ask4ska/ask4skaCyclone/Electronics/MEDIA/Arduino Mega+Ramps 1.4 + DRV8825.jpg

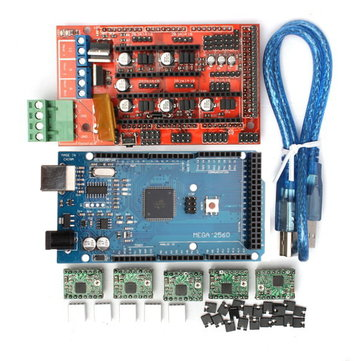
Electronics/MEDIA/Arduino Mega+Ramps 1.4 + DRV8825.jpg
