ask4ska/ask4skaCyclone/Electronics/MEDIA/NEMA_17.JPG

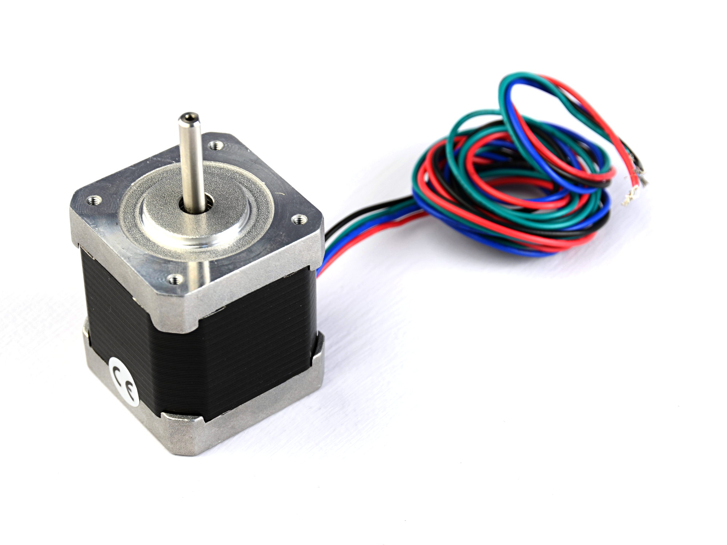
Electronics/MEDIA/NEMA_17.JPG
