ask4ska/ask4skaCyclone/Electronics/MEDIA/End Stop.jpg

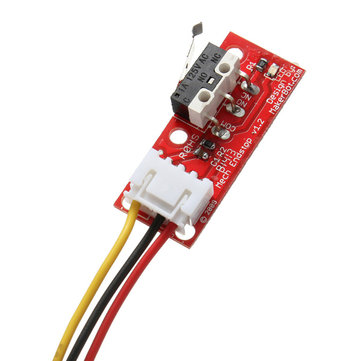
Electronics/MEDIA/End Stop.jpg
