ask4ska/ask4skaCyclone/Piezas y planos/Dremel Assembly.SLDASM

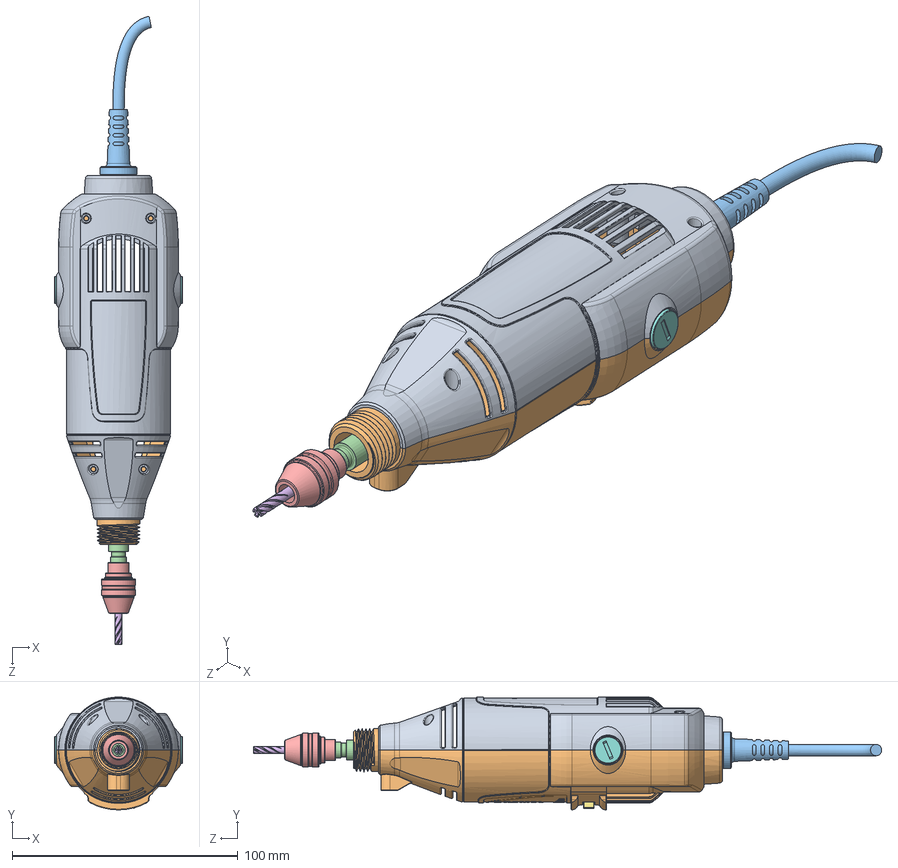
[picture p55: CAD file, 2017-06-02]
Piezas y planos/Dremel Assembly.SLDASM
56.7 x 50.0 x 278.4 mm
Dremel Left Half
Dremel Right Half
Dremel Chord
Dremel Chuck Mount
Dremel Chuck
End Mill for Dremel
Dremel Speed Lever
Dremel Motor Adjust x 2
