ask4ska/ask4skaCyclone/Piezas y planos/Carcassa.SLDASM

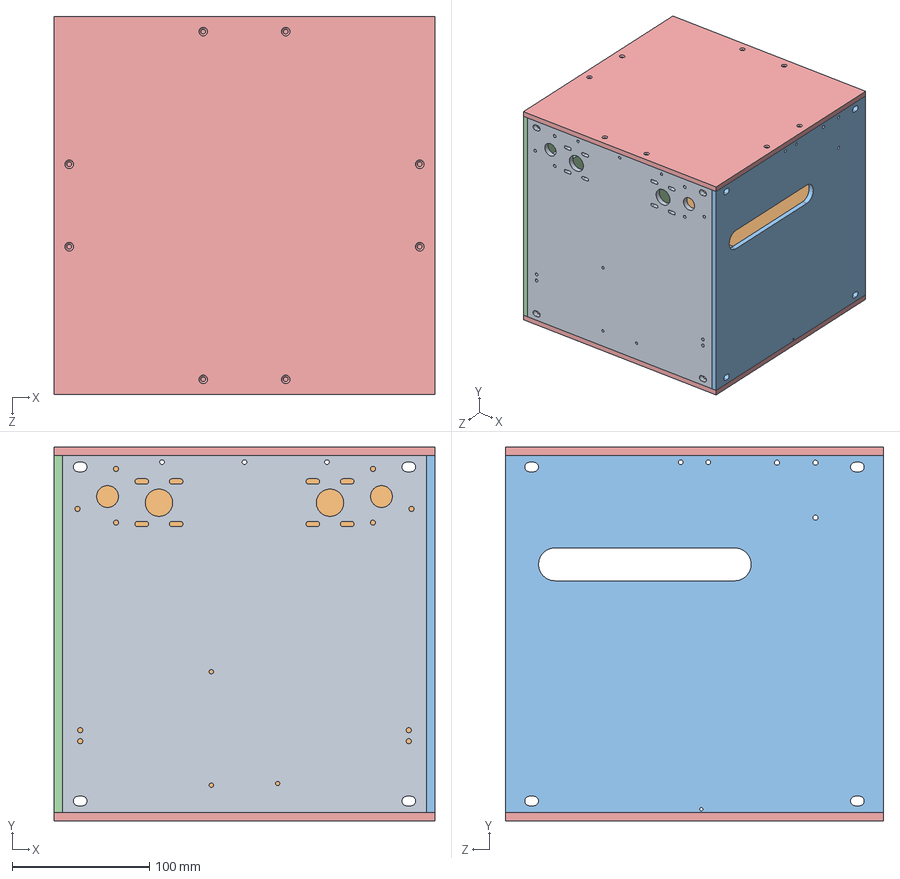
[picture p56: CAD file, 2017-06-02]
Piezas y planos/Carcassa.SLDASM
277.0 x 272.0 x 275.0 mm
carcassa darrere
carcassa davant
carcassa dreta
carcassa esquerra
carcassa tapa x 2
