ask4ska/ask4skaCyclone/Piezas y planos/Laser.SLDASM

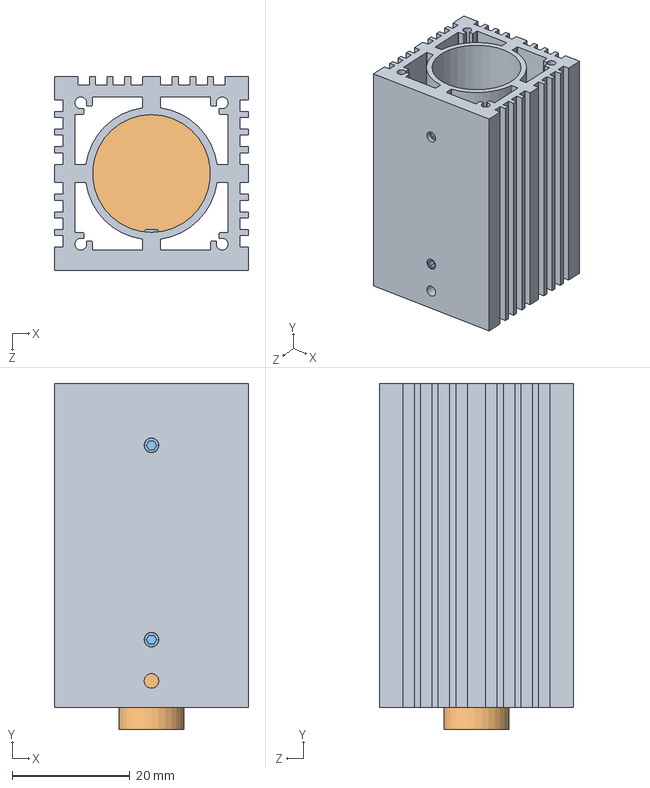
[picture p57: CAD file, 2017-06-02]
Piezas y planos/Laser.SLDASM
33.0 x 58.8 x 33.0 mm
Disipador pasiu
Làser
socket set screw flat point_iso x 2
