ask4ska/ask4skaCyclone/Piezas y planos/NEMA 17.SLDASM

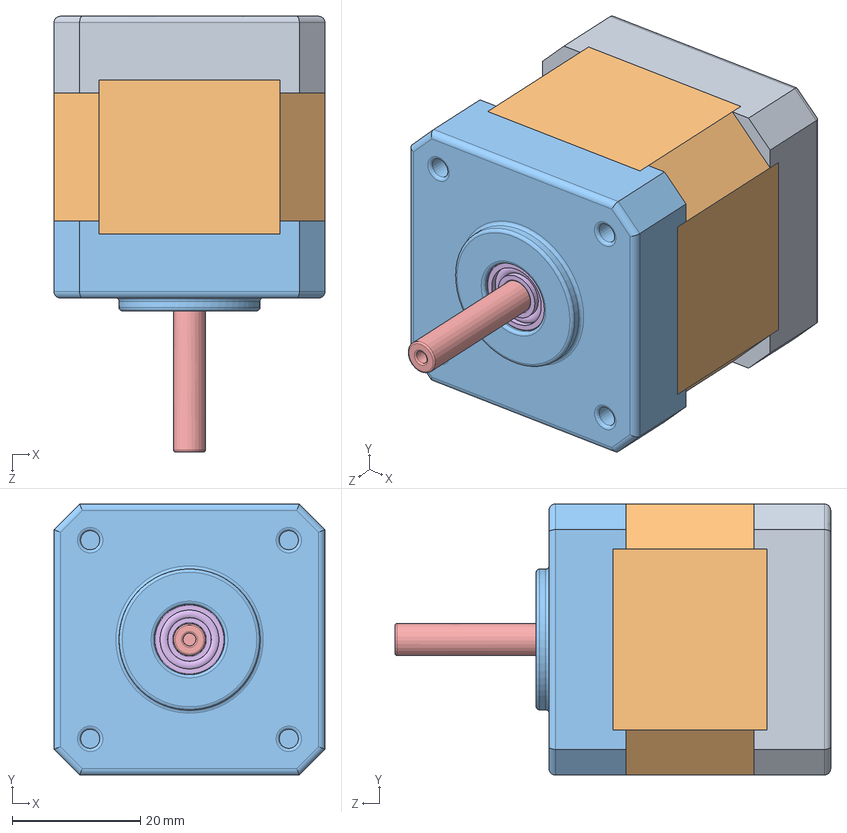
[picture p58: CAD file, 2017-06-02]
Piezas y planos/NEMA 17.SLDASM
42.3 x 42.3 x 68.0 mm
Base
Cuerpo
Tapa
pan cross head_am x 4
Eje
instrument ball bearing_68_am x 2
