ask4ska/ask4skaCyclone/Piezas y planos/cadenaens.SLDASM

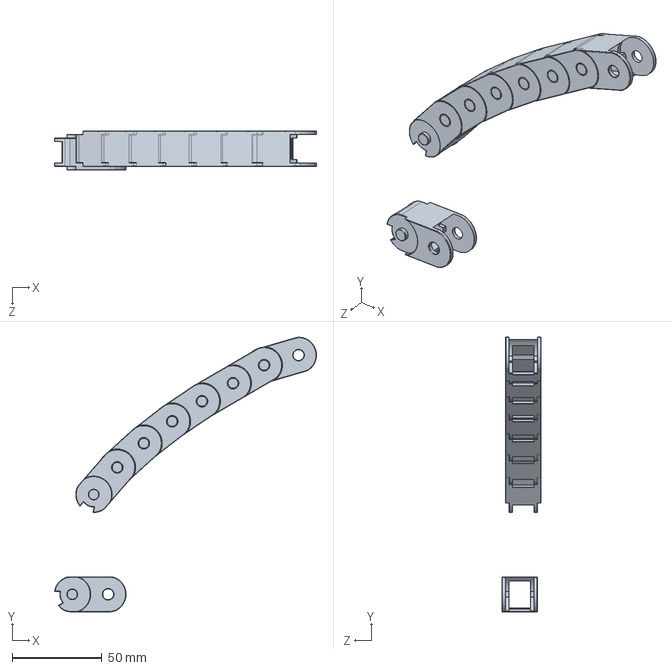
[picture p59: CAD file, 2017-06-02]
Piezas y planos/cadenaens.SLDASM
145.9 x 152.9 x 22.0 mm
cadenamod x 8
