ask4ska/ask4skaCyclone/Piezas y planos/G3D_Mech_Endstop.SLDASM

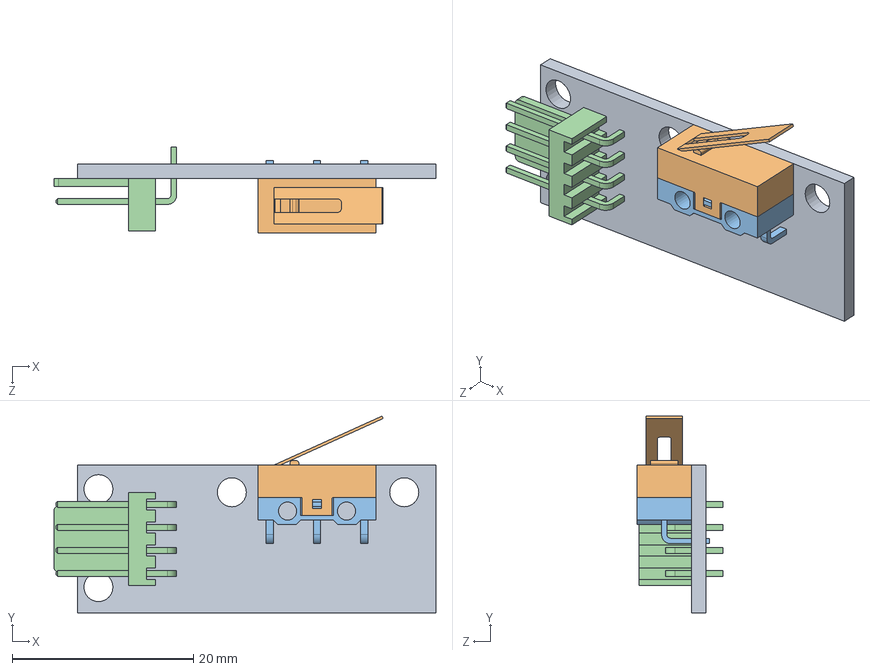
[picture p60: CAD file, 2017-06-02]
Piezas y planos/G3D_Mech_Endstop.SLDASM
42.1 x 21.7 x 9.46 mm
PCB_Mech_Endstop
Corpo1
Corpo2
SIL_4_P_90DEG
