ask4ska/ask4skaCyclone/Piezas y planos/Endstop.SLDASM

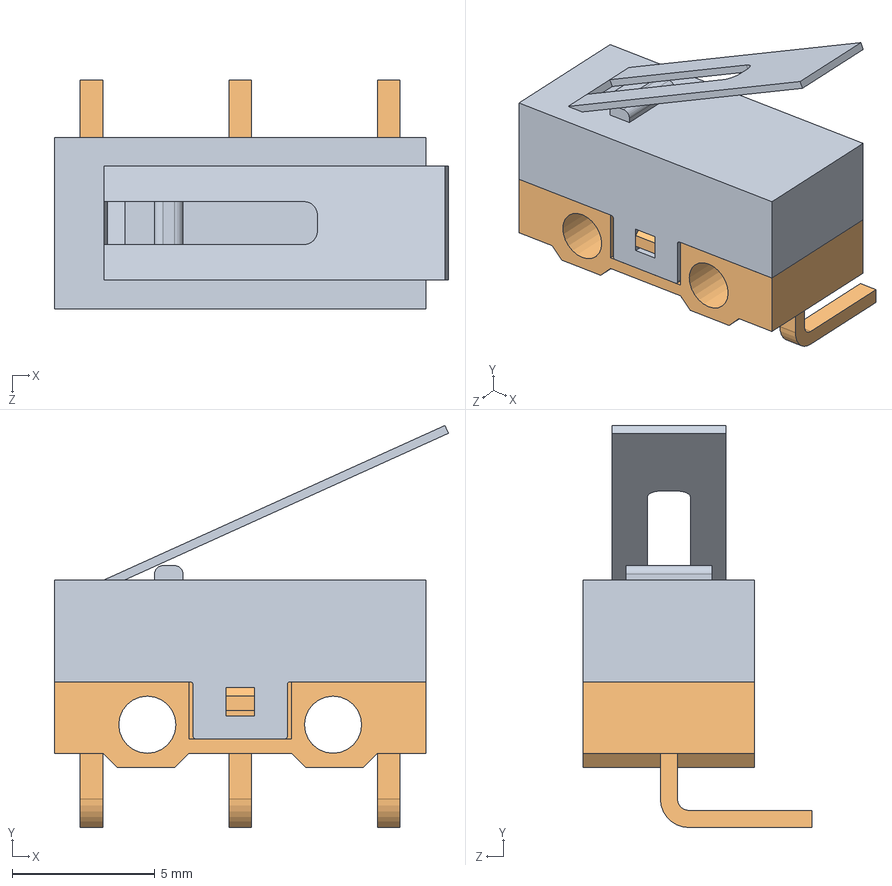
[picture p61: CAD file, 2017-06-02]
Piezas y planos/Endstop.SLDASM
13.8 x 14.1 x 8.00 mm
Corpo1
Corpo2
