ask4ska/ask4skaCyclone/Piezas y planos/Corpo1.SLDPRT

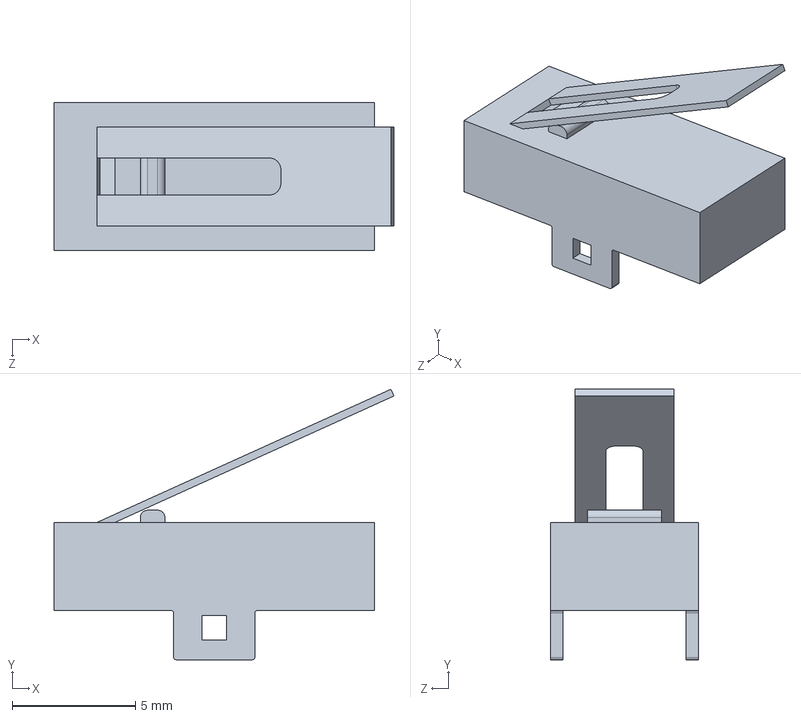
[picture p62: CAD file, 2017-06-02]
Piezas y planos/Corpo1.SLDPRT
13.8 x 11.0 x 6.00 mm
