ask4ska/ask4skaCyclone/Piezas y planos/Chapa desplegada - carcassa tapasota.DXF

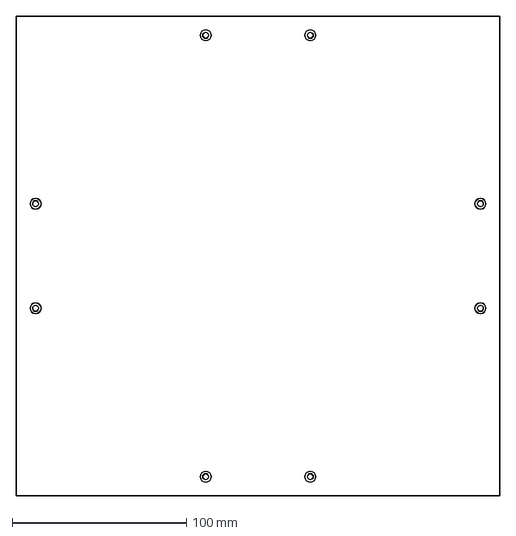
[picture p63: CAD file, 2017-06-02]
Piezas y planos/Chapa desplegada - carcassa tapasota.DXF
277.0 x 275.0 mm
