ask4ska/ask4skaCyclone/Piezas y planos/cadenamod.SLDPRT

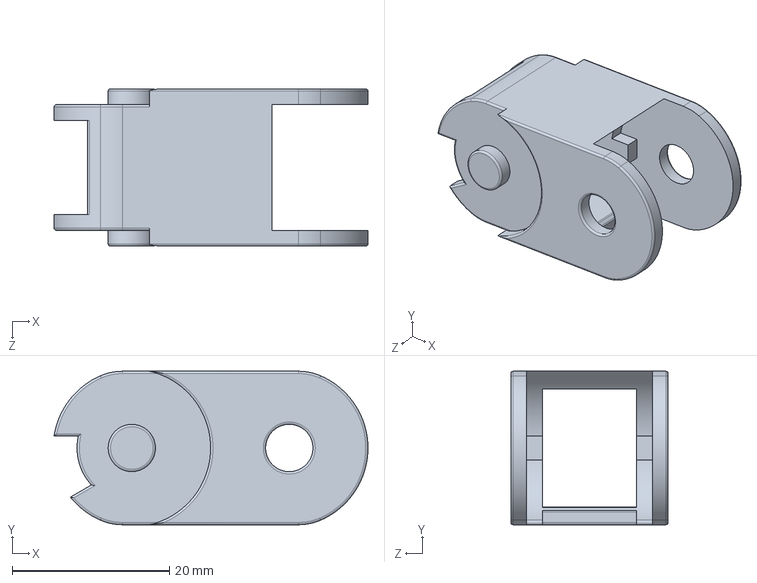
[picture p64: CAD file, 2017-06-02]
Piezas y planos/cadenamod.SLDPRT
39.9 x 19.5 x 20.0 mm
