ask4ska/ask4skaCyclone/Piezas y planos/carcassa dreta.SLDPRT

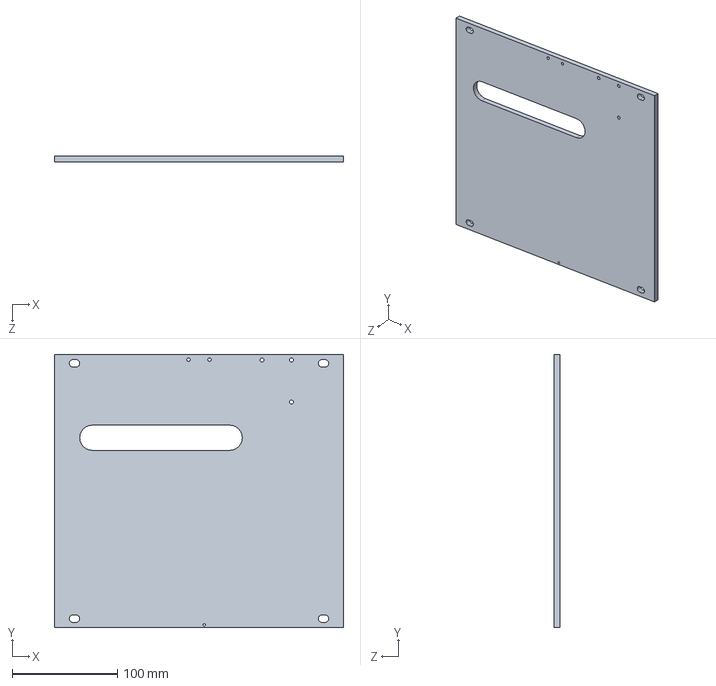
[picture p65: CAD file, 2017-06-02]
Piezas y planos/carcassa dreta.SLDPRT
275.0 x 260.0 x 6.00 mm
