ask4ska/ask4skaCyclone/Piezas y planos/pan cross head_am.sldprt

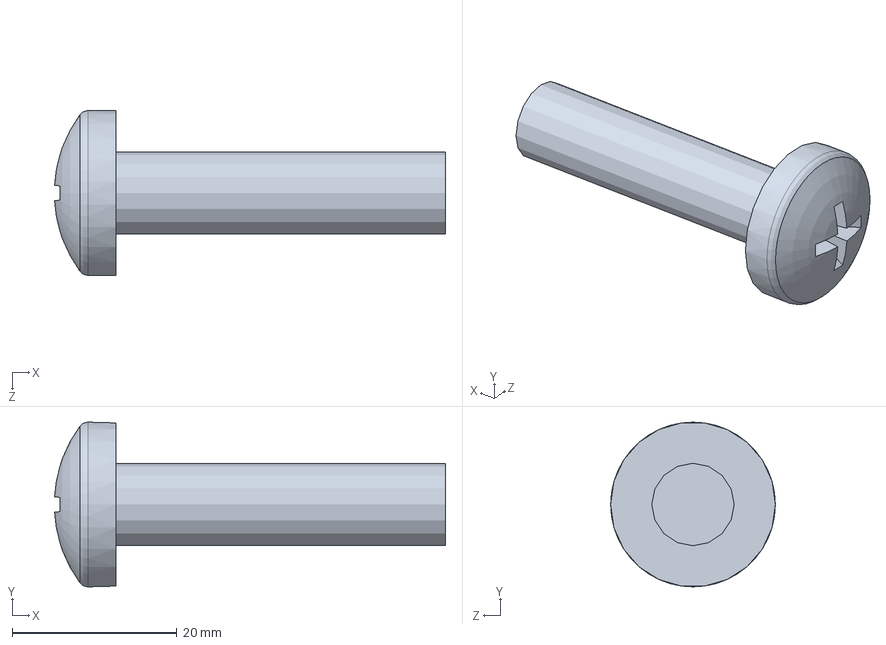
[picture p66: CAD file, 2017-06-02]
Piezas y planos/pan cross head_am.sldprt
47.4 x 20.0 x 20.0 mm
