ask4ska/ask4skaCyclone/Piezas y planos/End Mill for Dremel.SLDPRT

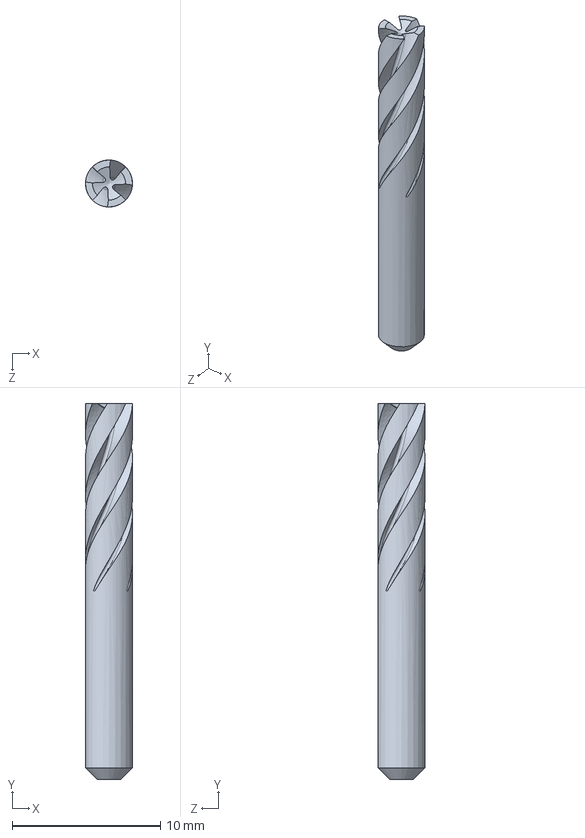
[picture p67: CAD file, 2017-06-02]
Piezas y planos/End Mill for Dremel.SLDPRT
3.17 x 25.4 x 3.17 mm
