ask4ska/ask4skaCyclone/Piezas y planos/Engranatge XY NEMAA.SLDPRT

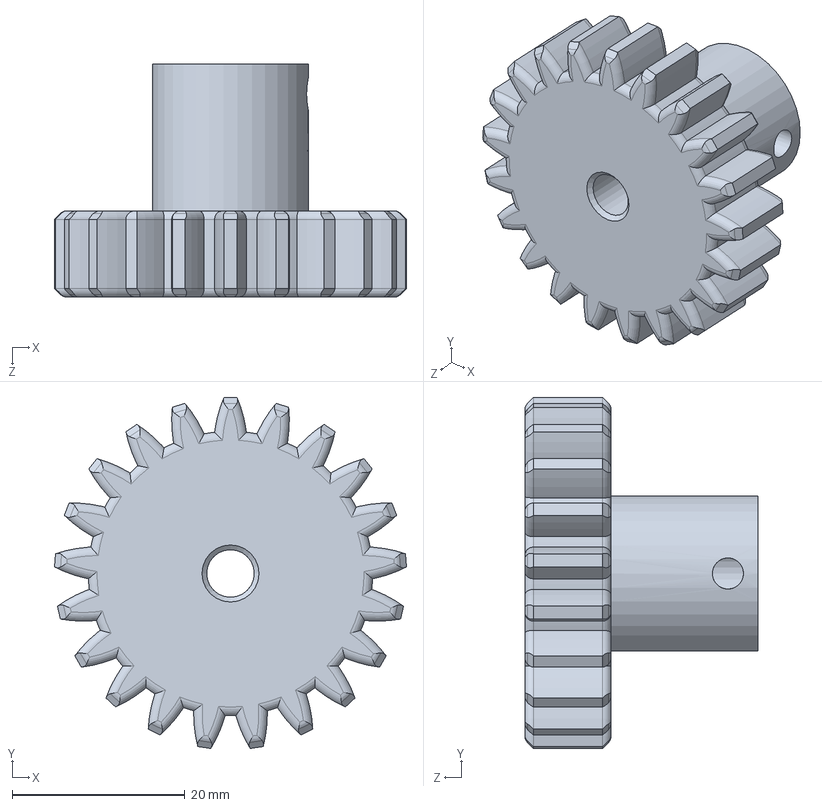
[picture p68: CAD file, 2017-06-02]
Piezas y planos/Engranatge XY NEMAA.SLDPRT
40.7 x 40.6 x 27.0 mm
