ask4ska/ask4skaCyclone/Piezas y planos/AutolevelV.2.2.SLDPRT

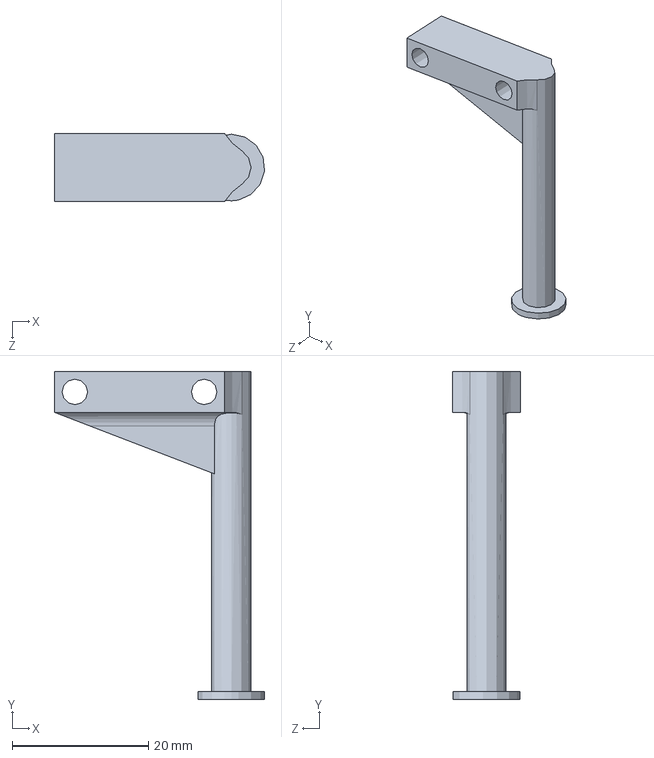
[picture p69: CAD file, 2017-06-02]
Piezas y planos/AutolevelV.2.2.SLDPRT
30.9 x 48.2 x 10.0 mm
