ask4ska/ask4skaCyclone/Piezas y planos/Chapa desplegada - carcassa darrere.DXF

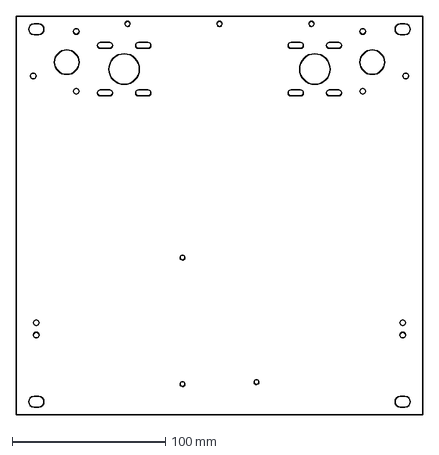
[picture p70: CAD file, 2017-06-02]
Piezas y planos/Chapa desplegada - carcassa darrere.DXF
265.0 x 260.0 mm
