ask4ska/ask4skaCyclone/Piezas y planos/Anclatge 75.SLDPRT

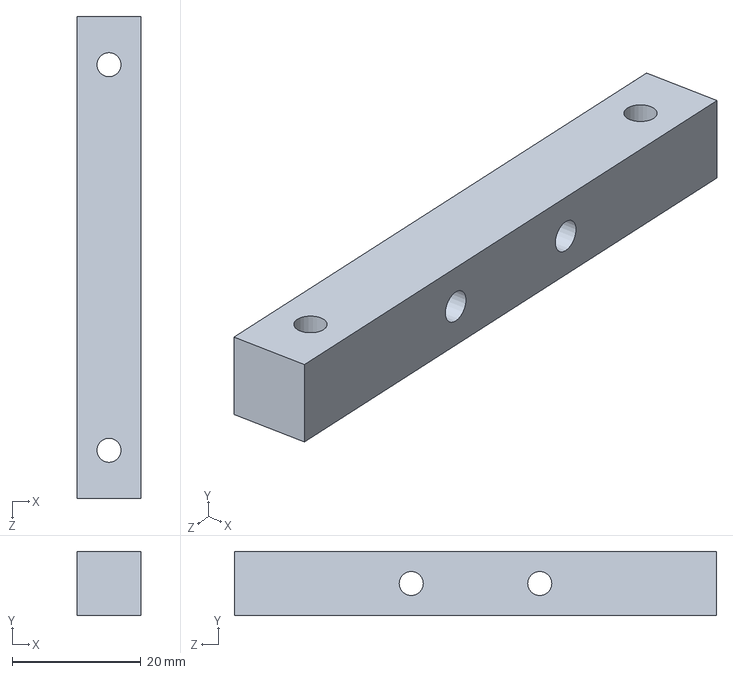
[picture p71: CAD file, 2017-06-02]
Piezas y planos/Anclatge 75.SLDPRT
10.0 x 10.0 x 75.0 mm
