ask4ska/ask4skaCyclone/Piezas y planos/carcassa darrere.SLDPRT

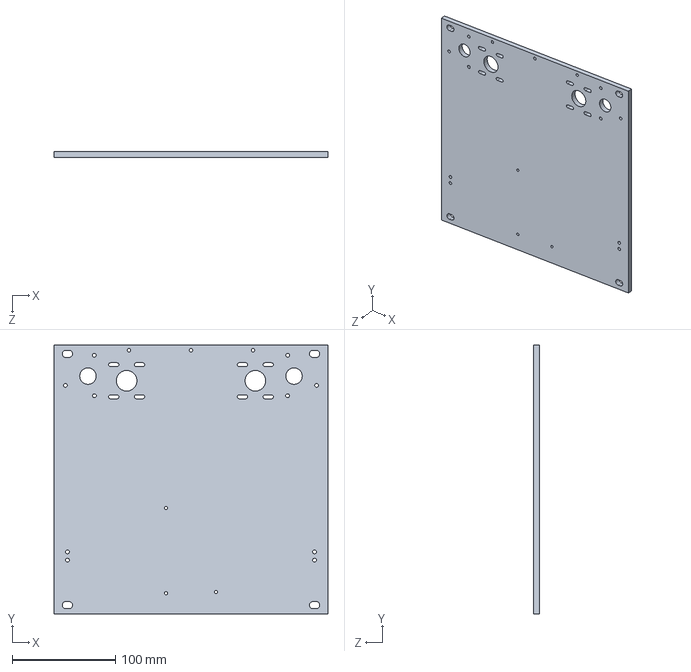
[picture p72: CAD file, 2017-06-02]
Piezas y planos/carcassa darrere.SLDPRT
265.0 x 260.0 x 6.00 mm
