ask4ska/ask4skaCyclone/Piezas y planos/Dremel Chuck Mount.SLDPRT

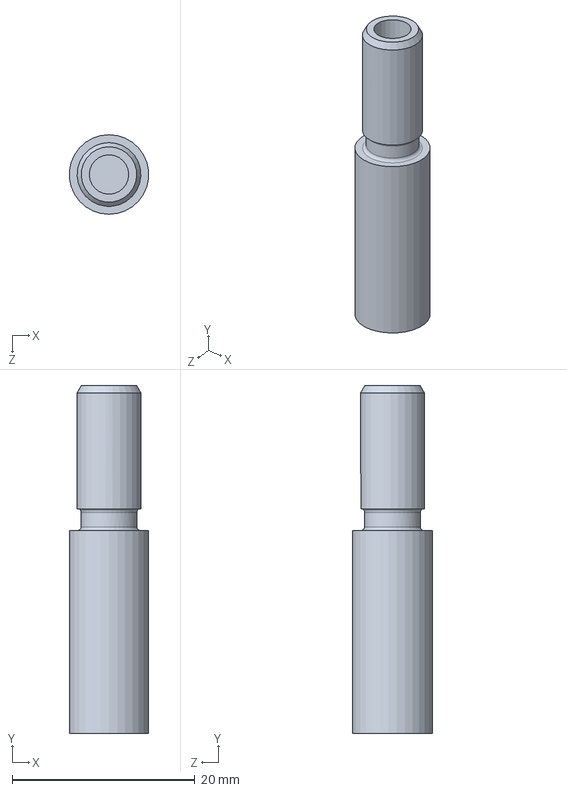
[picture p73: CAD file, 2017-06-02]
Piezas y planos/Dremel Chuck Mount.SLDPRT
8.66 x 38.1 x 8.71 mm
