ask4ska/ask4skaCyclone/Piezas y planos/pinza2.SLDPRT

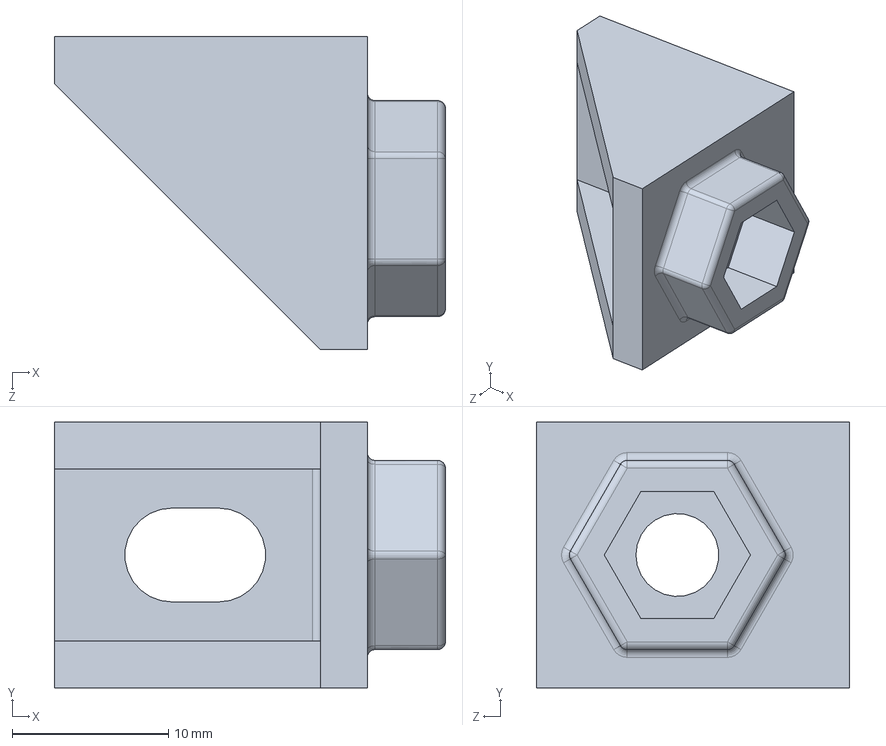
[picture p74: CAD file, 2017-06-02]
Piezas y planos/pinza2.SLDPRT
25.0 x 17.0 x 20.0 mm
