ask4ska/ask4skaCyclone/Piezas y planos/carcassa tapa.SLDPRT

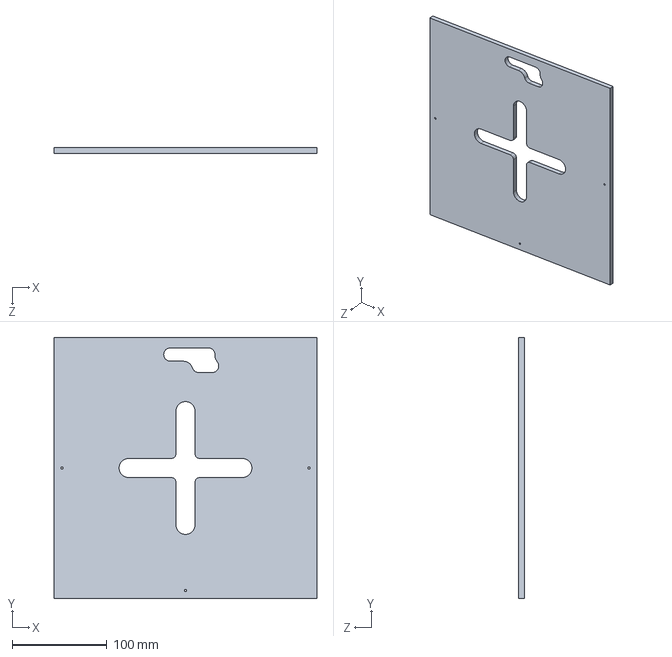
[picture p75: CAD file, 2017-06-02]
Piezas y planos/carcassa tapa.SLDPRT
277.0 x 275.0 x 6.00 mm
