ask4ska/ask4skaCyclone/Piezas y planos/Plataforma base.SLDPRT

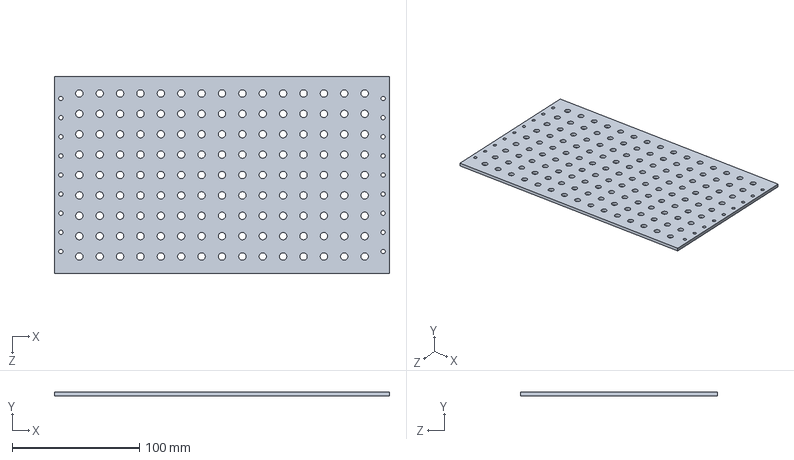
[picture p76: CAD file, 2017-06-02]
Piezas y planos/Plataforma base.SLDPRT
263.0 x 3.00 x 155.0 mm
