ask4ska/ask4skaCyclone/Piezas y planos/Abraçadera dremel.SLDPRT

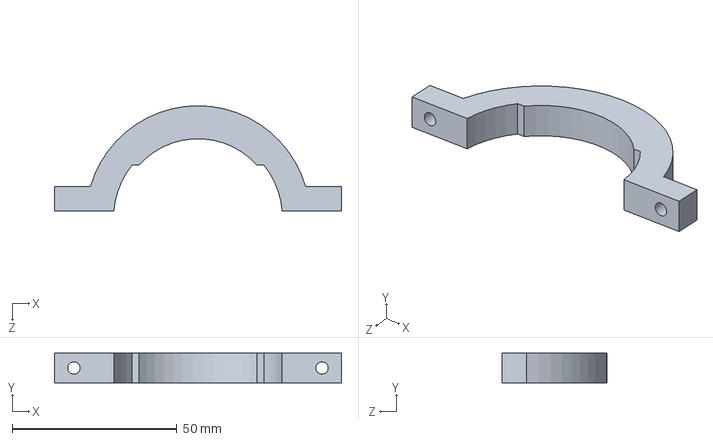
[picture p77: CAD file, 2017-06-02]
Piezas y planos/Abraçadera dremel.SLDPRT
87.1 x 9.00 x 32.0 mm
