ask4ska/ask4skaCyclone/Piezas y planos/Dremel Left Half.SLDPRT

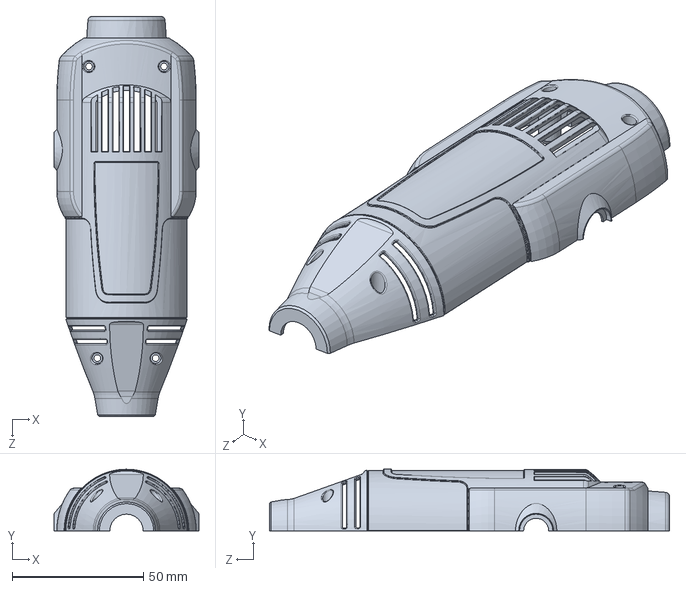
[picture p78: CAD file, 2017-06-02]
Piezas y planos/Dremel Left Half.SLDPRT
55.1 x 23.5 x 152.4 mm
