ask4ska/ask4skaCyclone/Piezas y planos/Dremel Speed Lever.sldprt

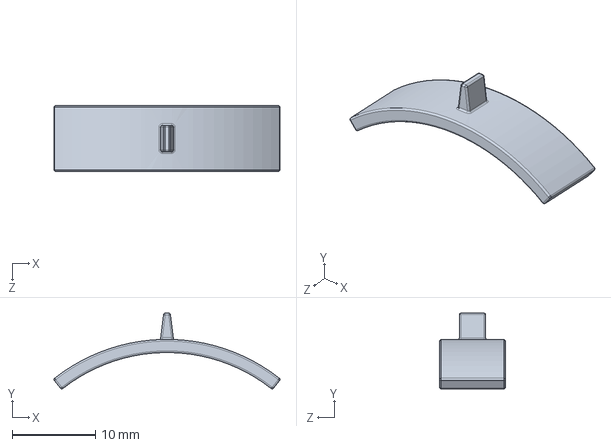
[picture p79: CAD file, 2017-06-02]
Piezas y planos/Dremel Speed Lever.sldprt
27.2 x 9.12 x 7.94 mm
