ask4ska/ask4skaCyclone/Piezas y planos/Base.SLDPRT

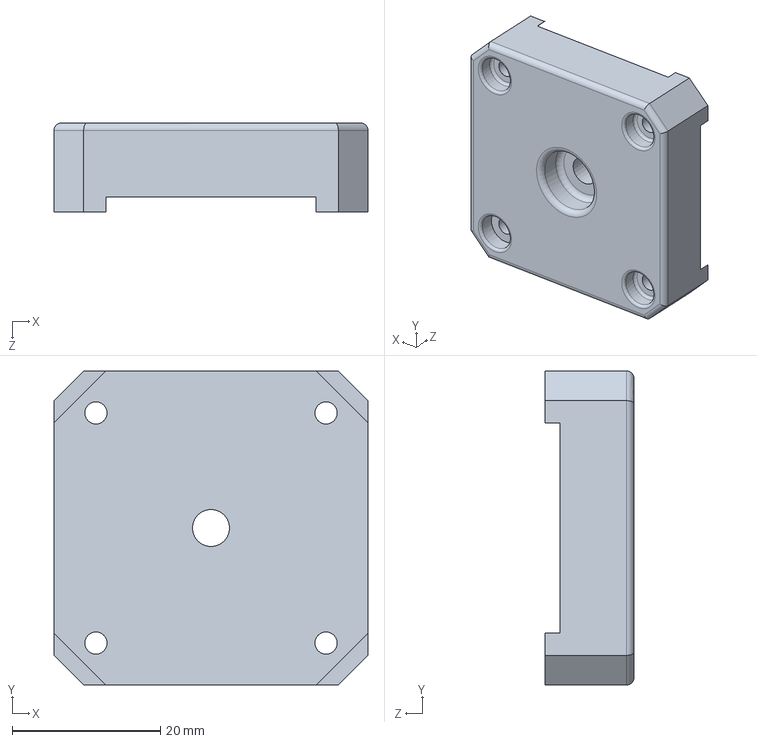
[picture p80: CAD file, 2017-06-02]
Piezas y planos/Base.SLDPRT
42.3 x 42.3 x 12.0 mm
