ask4ska/ask4skaCyclone/Piezas y planos/carro superior.SLDPRT

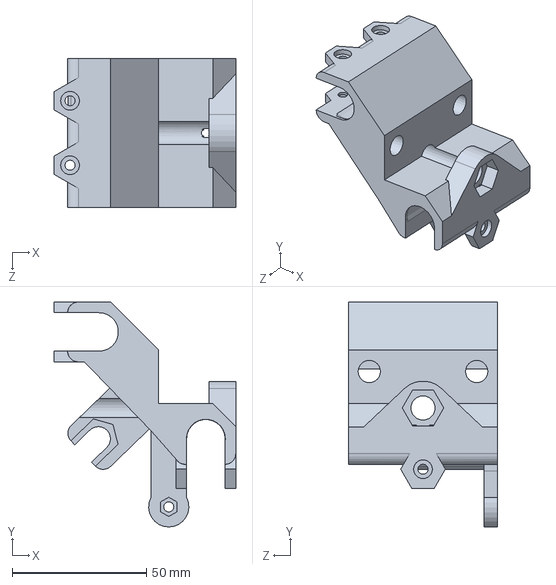
[picture p81: CAD file, 2017-06-02]
Piezas y planos/carro superior.SLDPRT
67.6 x 83.8 x 55.5 mm
