ask4ska/ask4skaCyclone/Piezas y planos/Matriz ex1.1.SLDPRT

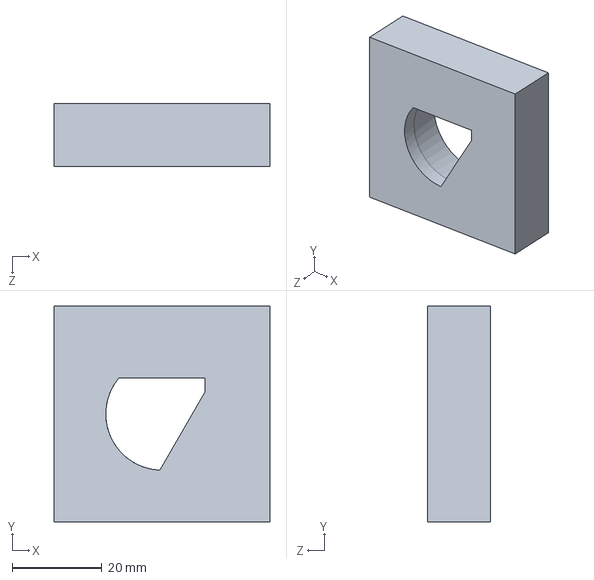
[picture p82: CAD file, 2017-06-02]
Piezas y planos/Matriz ex1.1.SLDPRT
48.0 x 48.0 x 14.0 mm
