ask4ska/ask4skaCyclone/Piezas y planos/Distanciador RAMPS2.SLDPRT

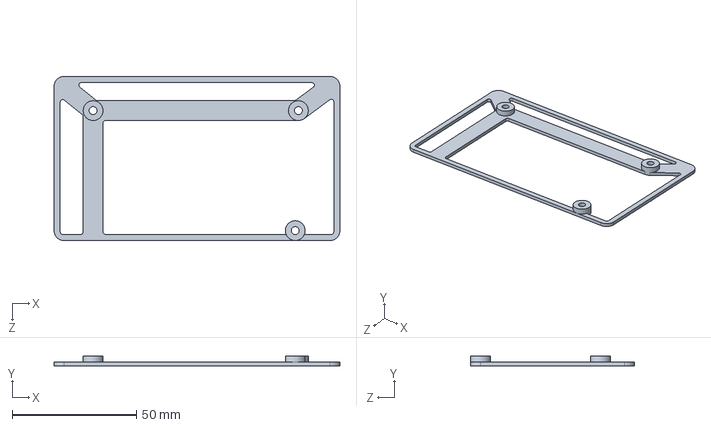
[picture p83: CAD file, 2017-06-02]
Piezas y planos/Distanciador RAMPS2.SLDPRT
115.0 x 4.00 x 66.0 mm
