ask4ska/ask4skaCyclone/Piezas y planos/Engranatge XY rosca.SLDPRT

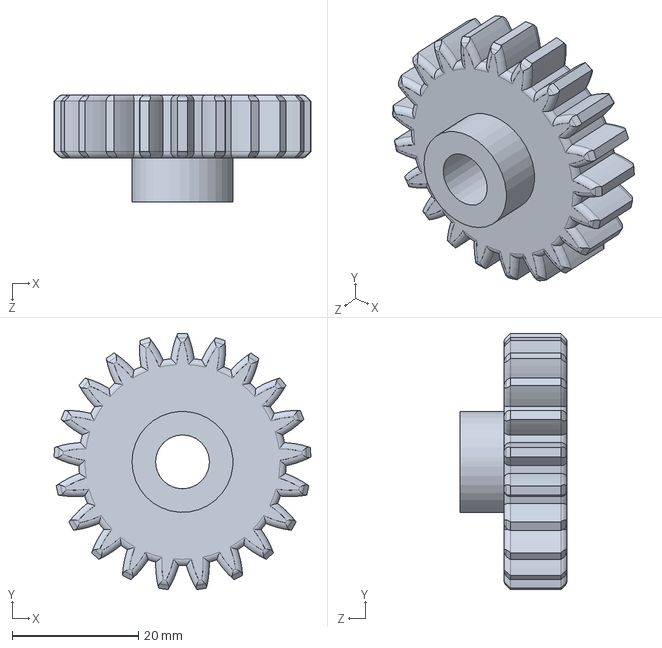
[picture p84: CAD file, 2017-06-02]
Piezas y planos/Engranatge XY rosca.SLDPRT
40.7 x 40.6 x 17.0 mm
