ask4ska/ask4skaCyclone/Piezas y planos/FijadorVarillaLisa.SLDPRT

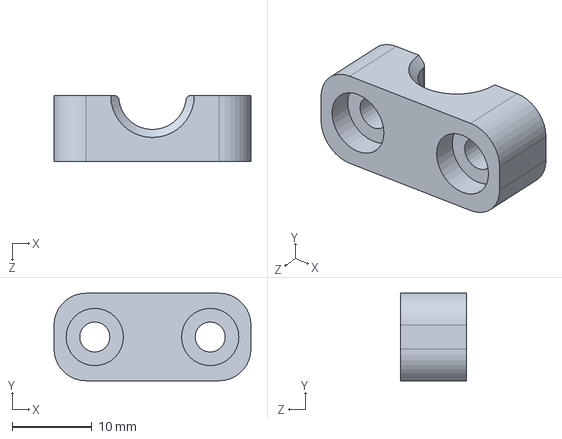
[picture p85: CAD file, 2017-06-02]
Piezas y planos/FijadorVarillaLisa.SLDPRT
24.8 x 11.0 x 8.25 mm
