ask4ska/ask4skaCyclone/Piezas y planos/FijadorVarillaLisa superior.SLDPRT

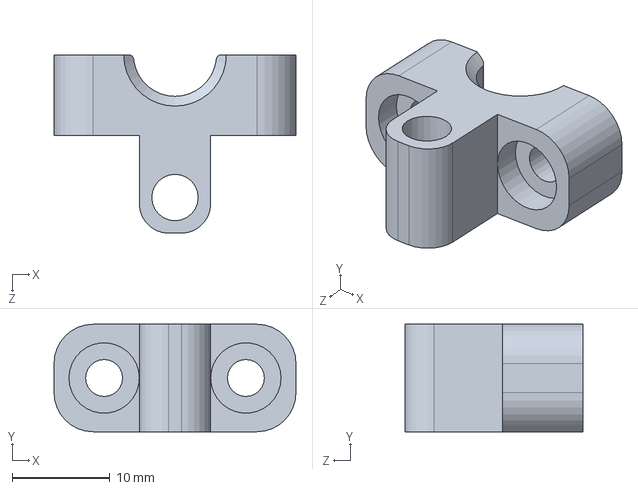
[picture p86: CAD file, 2017-06-02]
Piezas y planos/FijadorVarillaLisa superior.SLDPRT
24.8 x 11.0 x 18.2 mm
