ask4ska/ask4skaCyclone/Piezas y planos/Dremel Chuck.SLDPRT

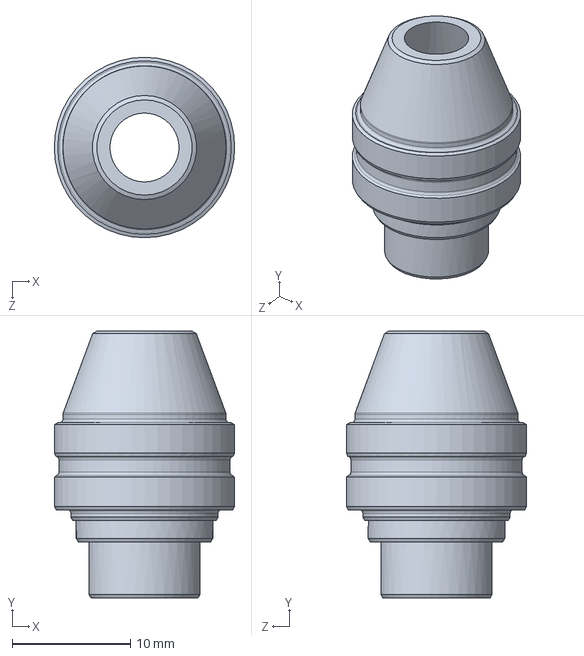
[picture p87: CAD file, 2017-06-02]
Piezas y planos/Dremel Chuck.SLDPRT
15.2 x 22.6 x 15.2 mm
