ask4ska/ask4skaCyclone/Piezas y planos/Esquinas.SLDPRT

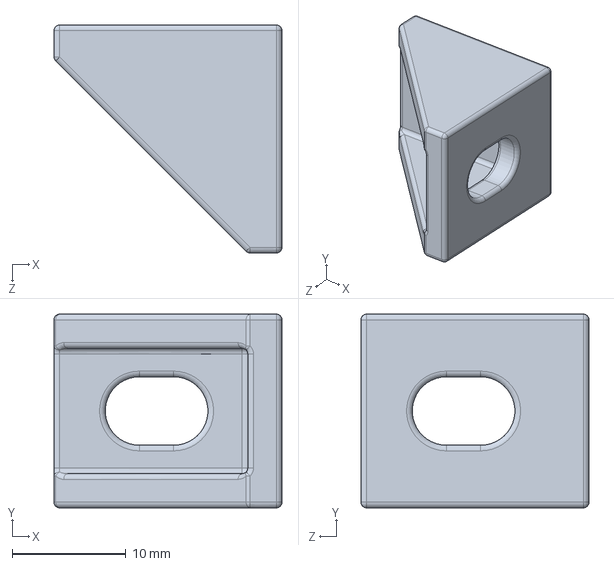
[picture p88: CAD file, 2017-06-02]
Piezas y planos/Esquinas.SLDPRT
20.0 x 17.0 x 20.0 mm
