ask4ska/ask4skaCyclone/Piezas y planos/Peça a mecanitzar.SLDPRT

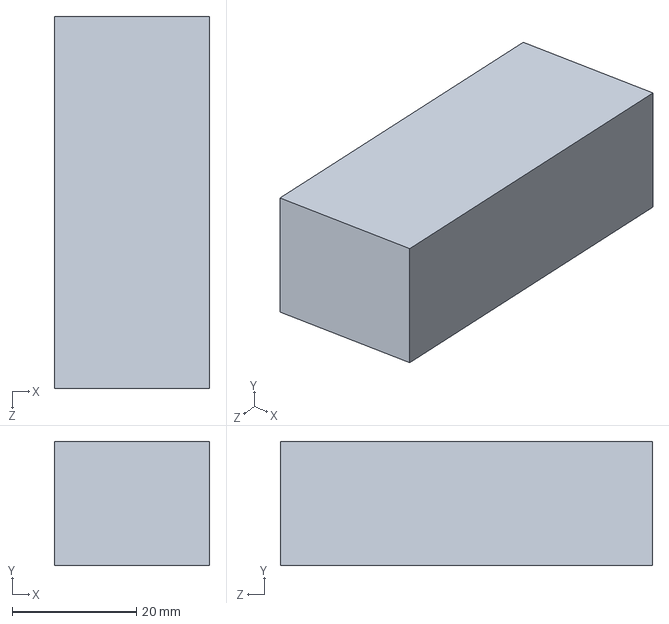
[picture p89: CAD file, 2017-06-02]
Piezas y planos/Peça a mecanitzar.SLDPRT
25.0 x 20.0 x 60.0 mm
