ask4ska/ask4skaCyclone/Piezas y planos/Anclatge 155.SLDPRT

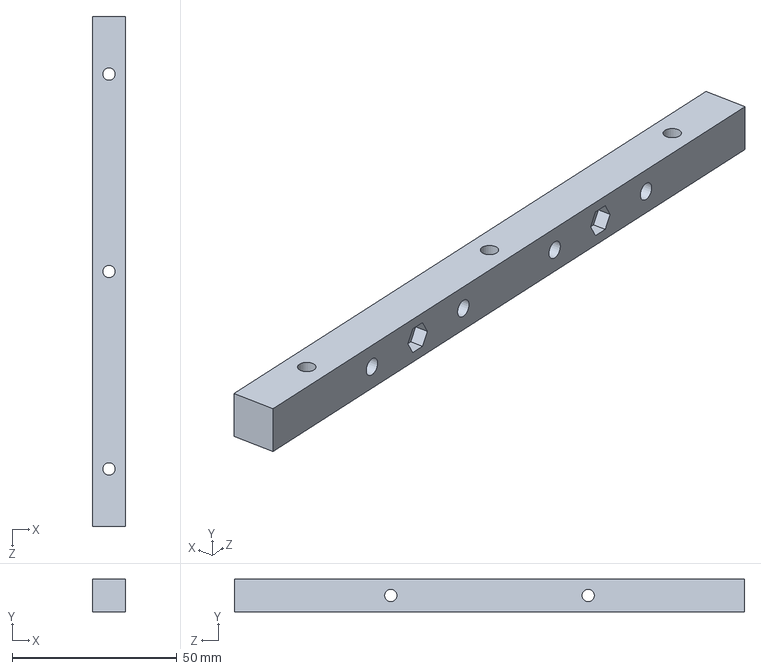
[picture p90: CAD file, 2017-06-02]
Piezas y planos/Anclatge 155.SLDPRT
10.0 x 10.0 x 155.0 mm
