ask4ska/ask4skaCyclone/Piezas y planos/PCB_Mech_Endstop.SLDPRT

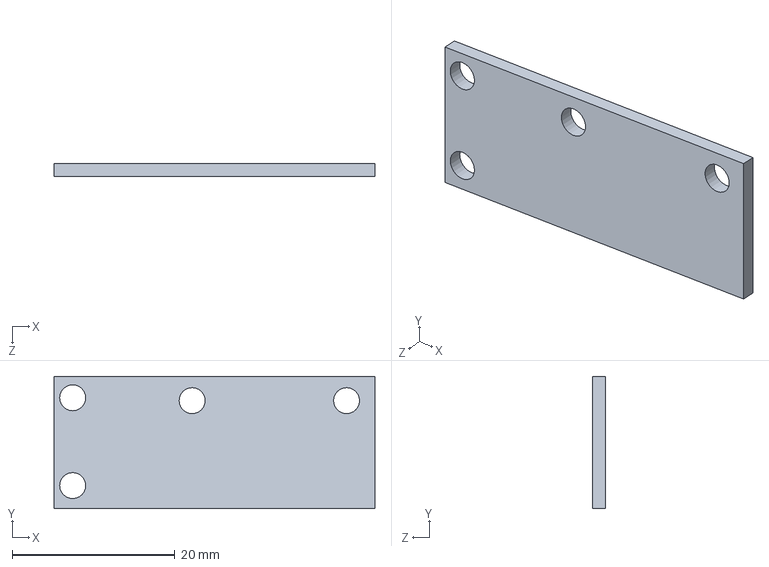
[picture p91: CAD file, 2017-06-02]
Piezas y planos/PCB_Mech_Endstop.SLDPRT
39.5 x 16.3 x 1.60 mm
