ask4ska/ask4skaCyclone/Piezas y planos/Muelle D11mm x H15mm.SLDPRT

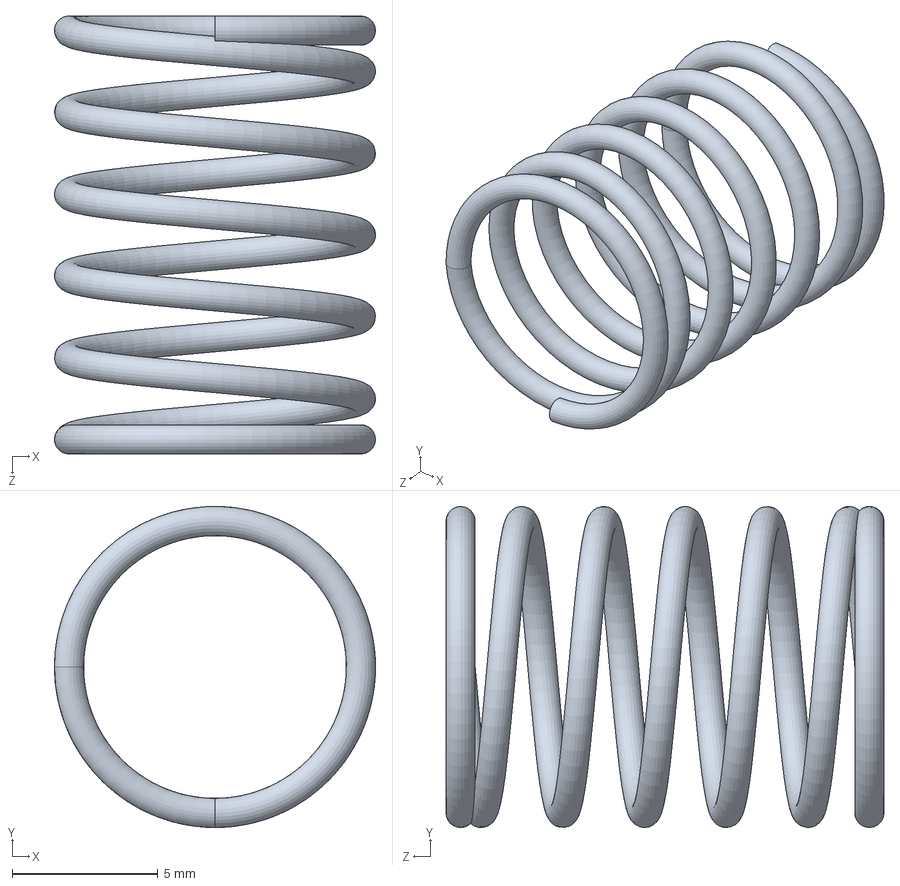
[picture p92: CAD file, 2017-06-02]
Piezas y planos/Muelle D11mm x H15mm.SLDPRT
11.0 x 11.0 x 15.0 mm
