ask4ska/ask4skaCyclone/Piezas y planos/Chapa desplegada - carcassa davant.DXF

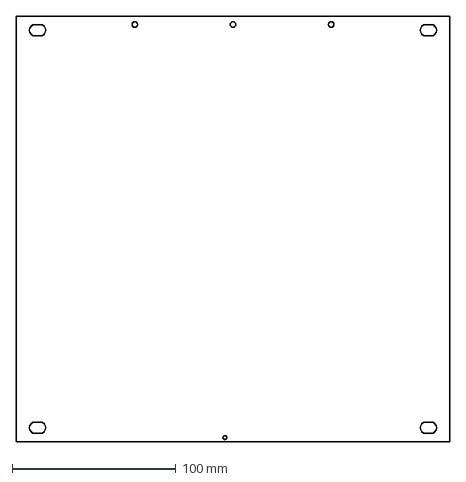
[picture p93: CAD file, 2017-06-02]
Piezas y planos/Chapa desplegada - carcassa davant.DXF
265.0 x 260.0 mm
