ask4ska/ask4skaCyclone/Piezas y planos/Chapa desplegada - carcassa tapa.DXF

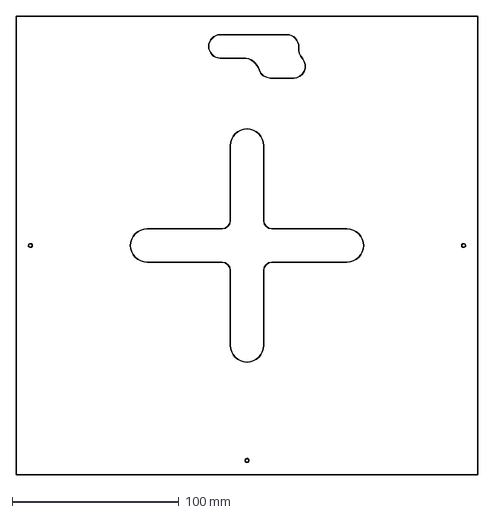
[picture p94: CAD file, 2017-06-02]
Piezas y planos/Chapa desplegada - carcassa tapa.DXF
277.0 x 275.0 mm
