ask4ska/ask4skaCyclone/Piezas y planos/Engranatge Z rosca.SLDPRT

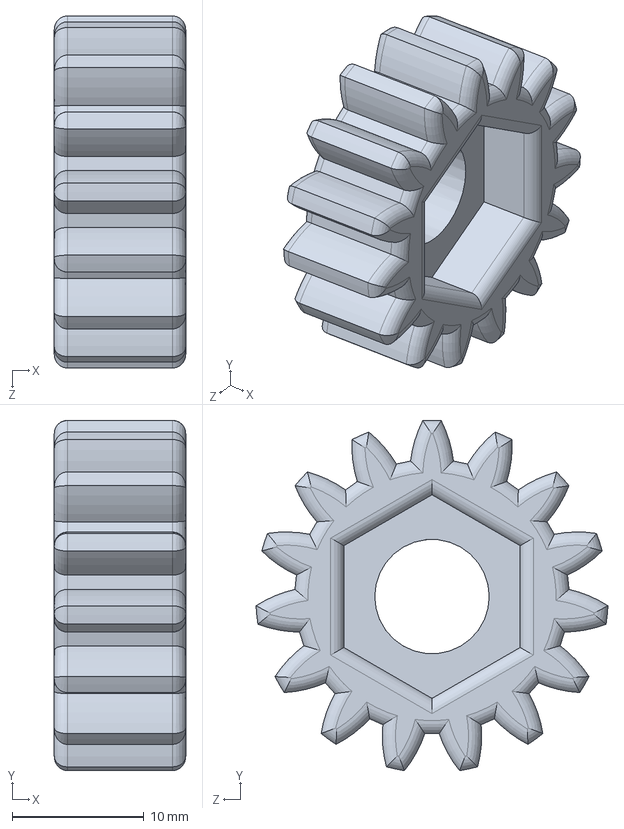
[picture p95: CAD file, 2017-06-02]
Piezas y planos/Engranatge Z rosca.SLDPRT
10.0 x 26.6 x 26.8 mm
