ask4ska/ask4skaCyclone/Piezas y planos/Disipador pasiu.SLDPRT

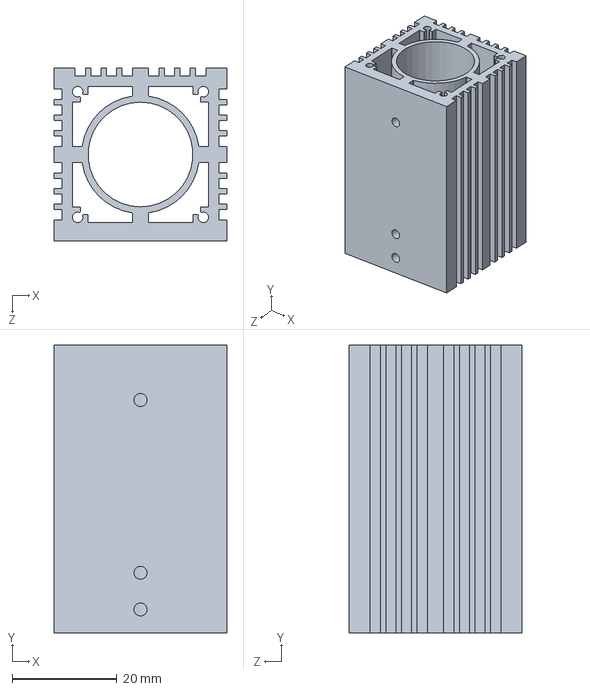
[picture p96: CAD file, 2017-06-02]
Piezas y planos/Disipador pasiu.SLDPRT
33.0 x 55.0 x 33.0 mm
