ask4ska/ask4skaCyclone/Piezas y planos/Dremel Right Half.SLDPRT

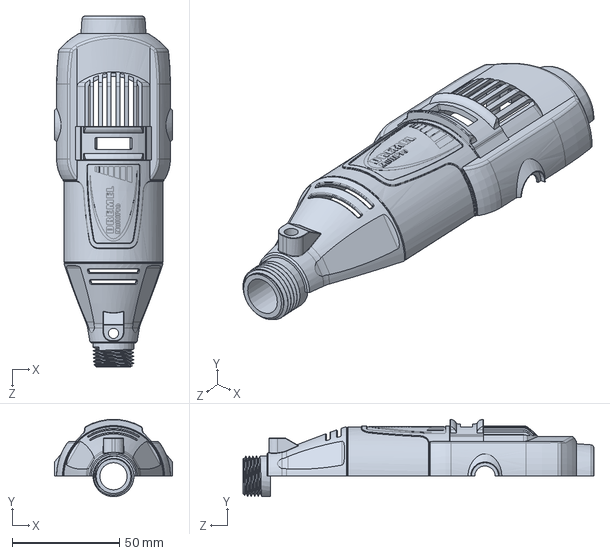
[picture p97: CAD file, 2017-06-02]
Piezas y planos/Dremel Right Half.SLDPRT
55.1 x 36.0 x 163.5 mm
