ask4ska/ask4skaCyclone/Piezas y planos/Cuerpo.SLDPRT

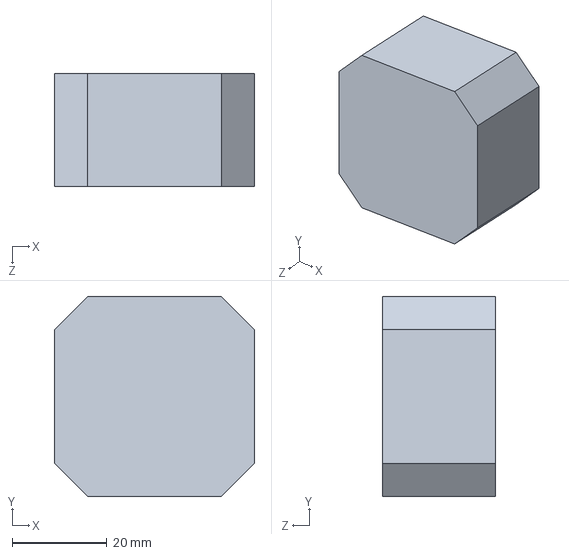
[picture p98: CAD file, 2017-06-02]
Piezas y planos/Cuerpo.SLDPRT
42.3 x 42.3 x 24.0 mm
