ask4ska/ask4skaCyclone/Piezas y planos/Làser.SLDPRT

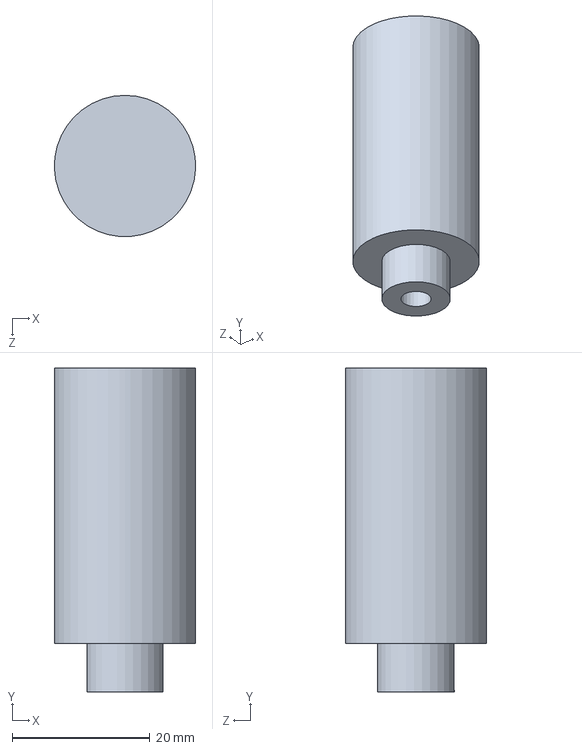
[picture p99: CAD file, 2017-06-02]
Piezas y planos/Làser.SLDPRT
20.5 x 47.0 x 20.5 mm
