ask4ska/ask4skaCyclone/Piezas y planos/Dremel Motor Adjust.SLDPRT

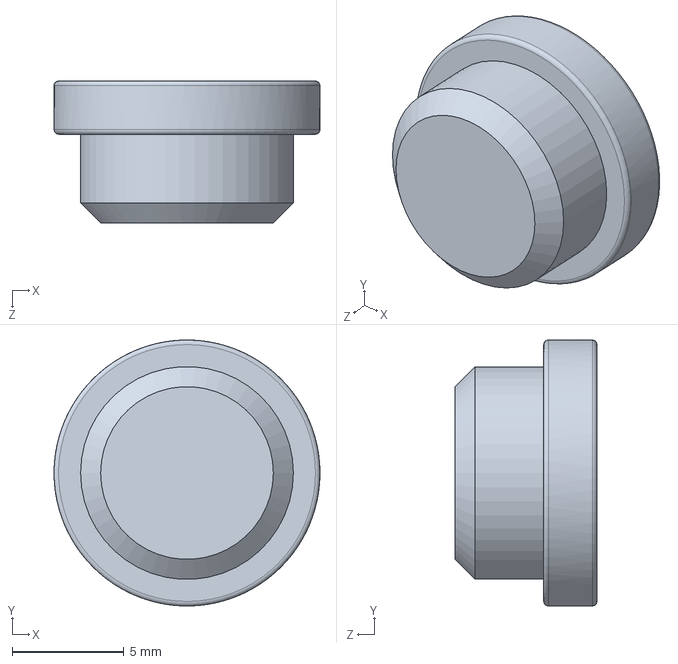
[picture p100: CAD file, 2017-06-02]
Piezas y planos/Dremel Motor Adjust.SLDPRT
11.9 x 11.9 x 6.35 mm
