ask4ska/ask4skaCyclone/Piezas y planos/Peça a mecanitzar prima.SLDPRT

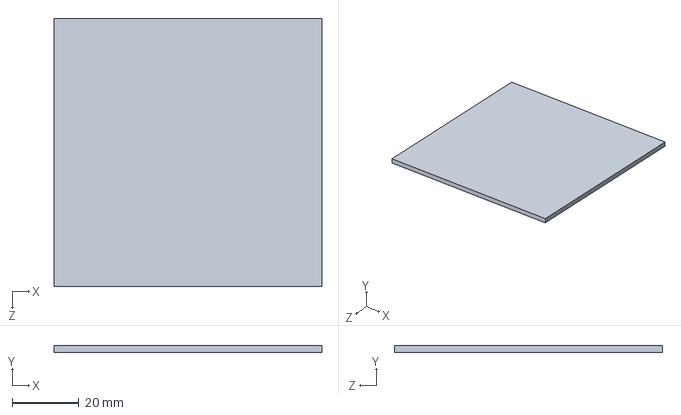
[picture p101: CAD file, 2017-06-02]
Piezas y planos/Peça a mecanitzar prima.SLDPRT
80.0 x 2.00 x 80.0 mm
