ask4ska/ask4skaCyclone/Piezas y planos/pinçasup.SLDPRT

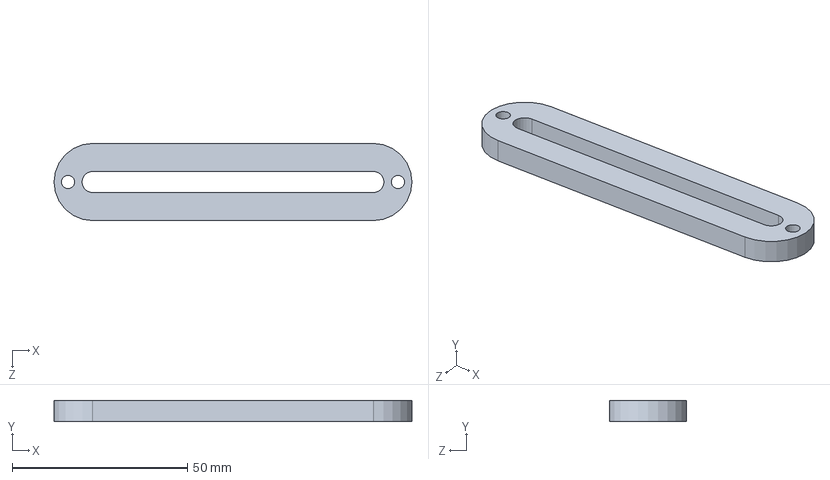
[picture p102: CAD file, 2017-06-02]
Piezas y planos/pinçasup.SLDPRT
102.0 x 6.00 x 22.0 mm
