ask4ska/ask4skaCyclone/Piezas y planos/femellapinçasup.SLDPRT

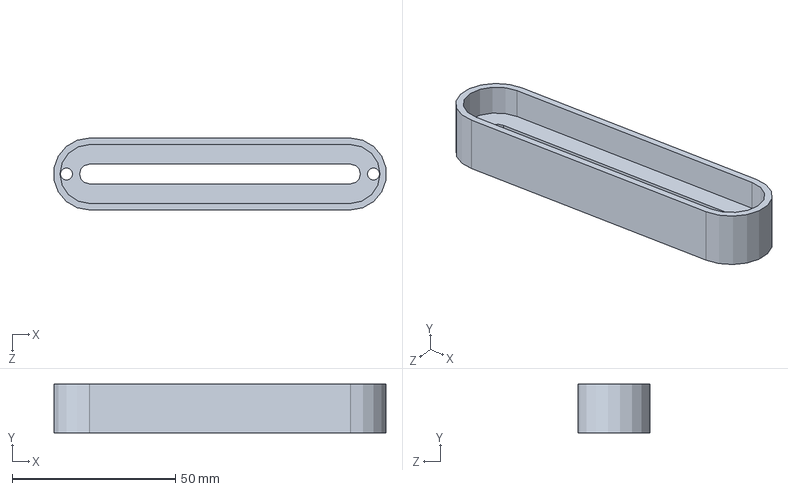
[picture p103: CAD file, 2017-06-02]
Piezas y planos/femellapinçasup.SLDPRT
101.7 x 15.0 x 22.0 mm
