ask4ska/ask4skaCyclone/Piezas y planos/SIL_4_P_90DEG.SLDPRT

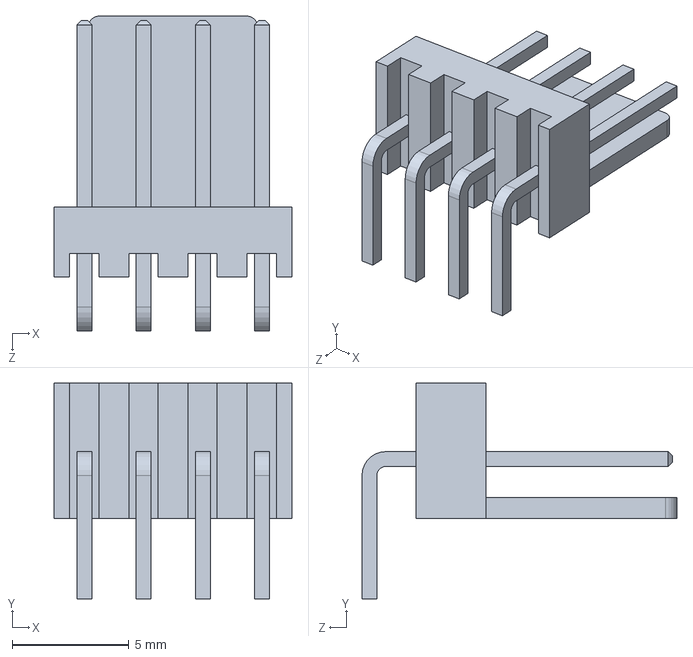
[picture p104: CAD file, 2017-06-02]
Piezas y planos/SIL_4_P_90DEG.SLDPRT
10.2 x 9.26 x 13.5 mm
