ask4ska/ask4skaCyclone/Piezas y planos/Lado derecho combo.SLDPRT

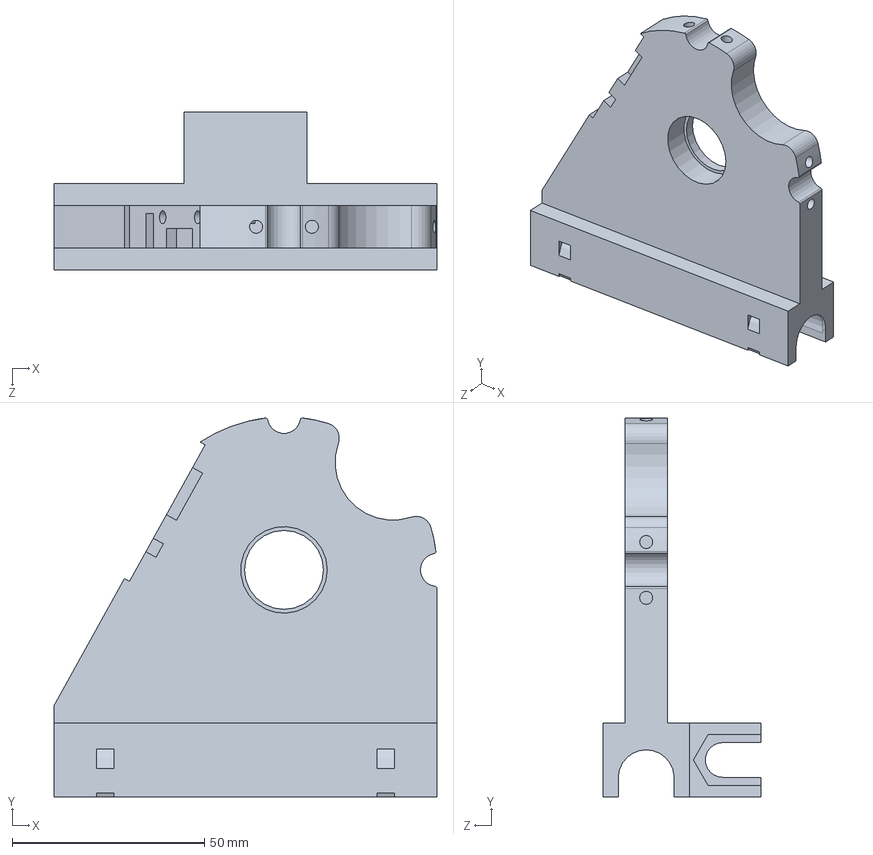
[picture p106: CAD file, 2017-06-02]
Piezas y planos/Lado derecho combo.SLDPRT
99.5 x 98.5 x 41.1 mm
