ask4ska/ask4skaCyclone/Piezas y planos/Pieza4combo.SLDPRT

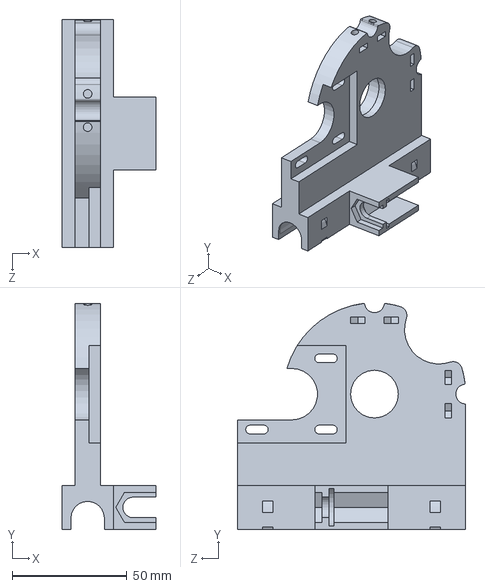
[picture p107: CAD file, 2017-06-02]
Piezas y planos/Pieza4combo.SLDPRT
41.1 x 98.5 x 99.5 mm
