ask4ska/ask4skaCyclone/Piezas y planos/imán.SLDPRT

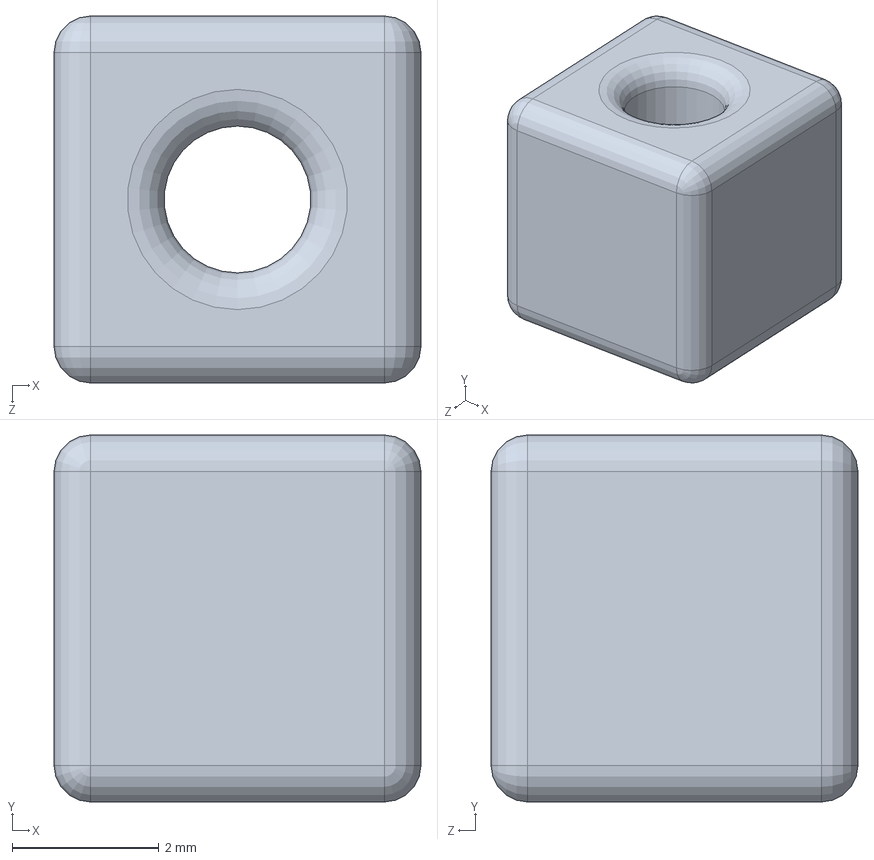
[picture p108: CAD file, 2017-06-02]
Piezas y planos/imán.SLDPRT
5.00 x 5.00 x 5.00 mm
