ask4ska/ask4skaCyclone/Piezas y planos/femellapinçaindividual.SLDPRT

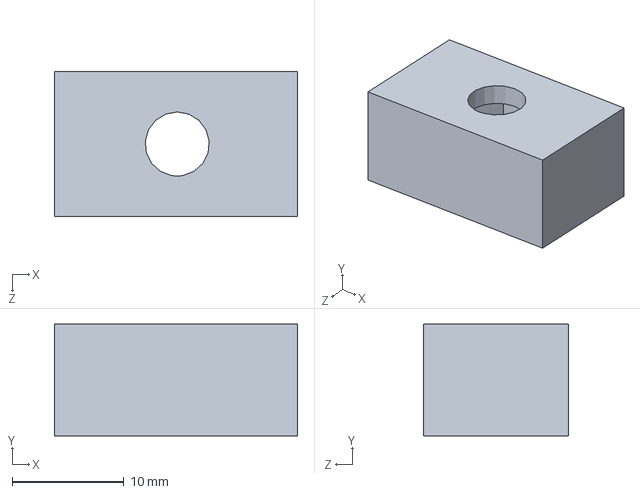
[picture p109: CAD file, 2017-06-02]
Piezas y planos/femellapinçaindividual.SLDPRT
21.8 x 10.0 x 13.0 mm
