ask4ska/ask4skaCyclone/Piezas y planos/Dremel Chord.SLDPRT

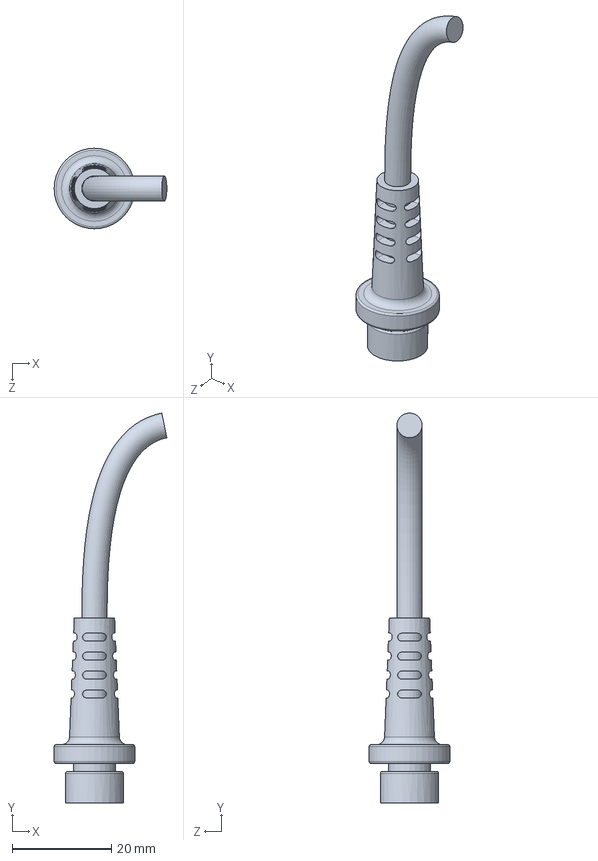
[picture p110: CAD file, 2017-06-02]
Piezas y planos/Dremel Chord.SLDPRT
22.7 x 78.4 x 16.2 mm
