ask4ska/ask4skaCyclone/Piezas y planos/radial ball bearing_68_din.sldprt

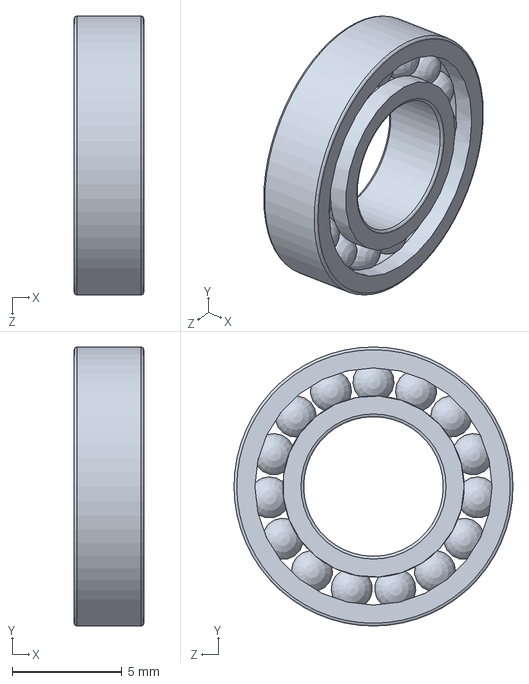
[picture p111: CAD file, 2017-06-02]
Piezas y planos/radial ball bearing_68_din.sldprt
3.17 x 12.7 x 12.7 mm
