ask4ska/ask4skaCyclone/Piezas y planos/laserfan.SLDPRT

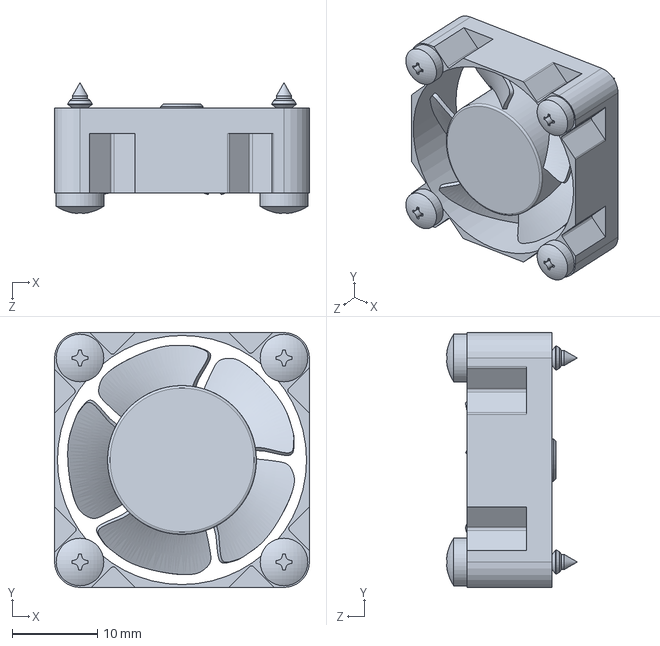
[picture p112: CAD file, 2017-06-02]
Piezas y planos/laserfan.SLDPRT
30.0 x 30.0 x 15.4 mm
