ask4ska/ask4skaCyclone/Piezas y planos/femellapinça.SLDPRT

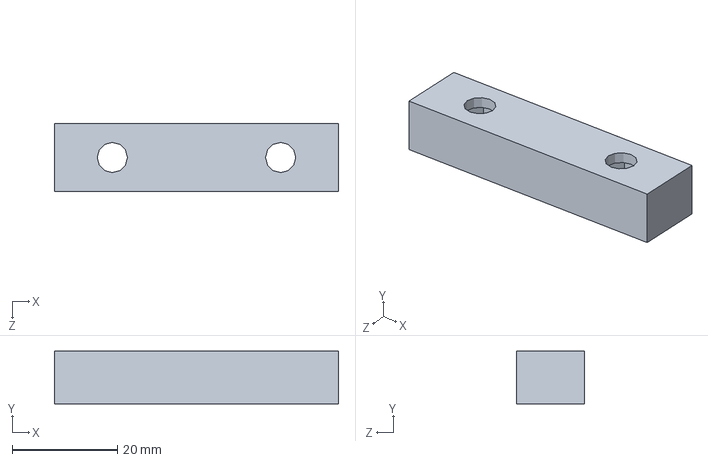
[picture p113: CAD file, 2017-06-02]
Piezas y planos/femellapinça.SLDPRT
54.0 x 10.0 x 13.0 mm
