ask4ska/ask4skaCyclone/Piezas y planos/Corpo2.SLDPRT

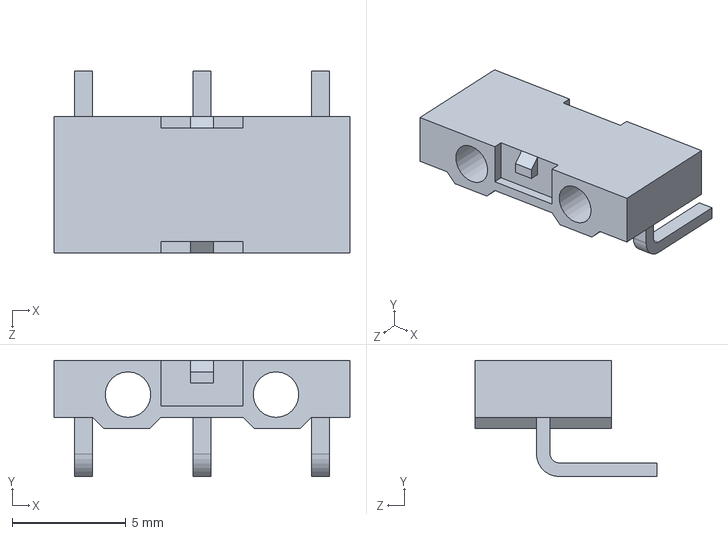
[picture p114: CAD file, 2017-06-02]
Piezas y planos/Corpo2.SLDPRT
13.0 x 5.10 x 8.00 mm
