ask4ska/ask4skaCyclone/Piezas y planos/separador endstops.SLDPRT

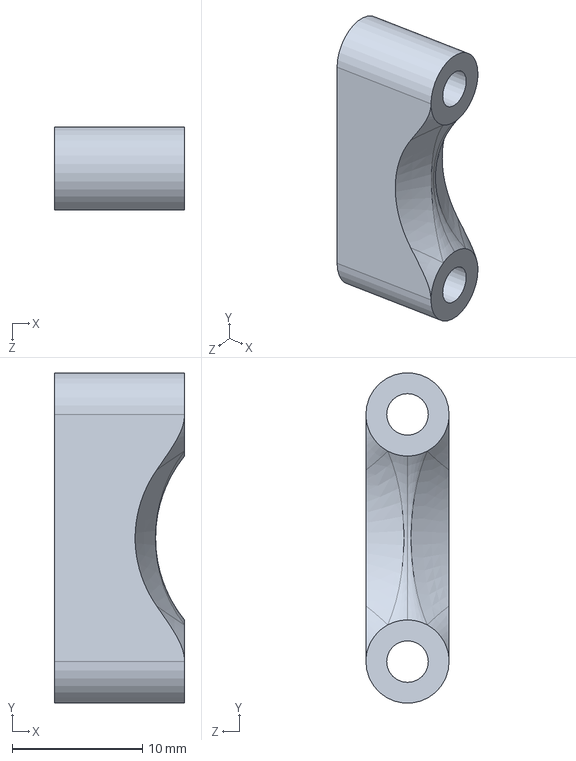
[picture p115: CAD file, 2017-06-02]
Piezas y planos/separador endstops.SLDPRT
10.0 x 25.4 x 6.40 mm
