ask4ska/ask4skaCyclone/Piezas y planos/LM8UU.SLDPRT

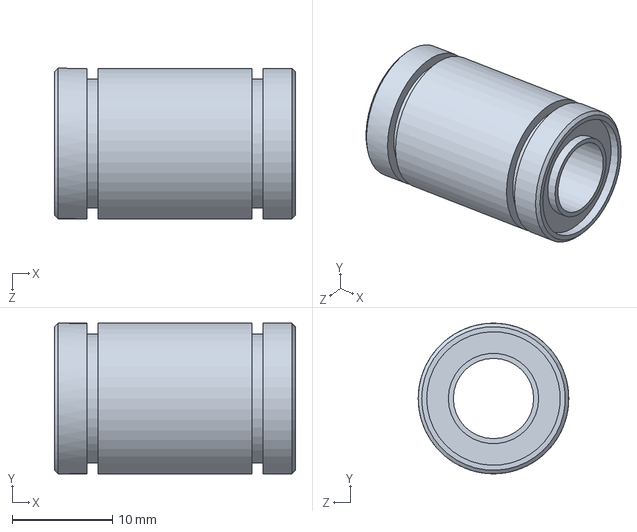
[picture p116: CAD file, 2017-06-02]
Piezas y planos/LM8UU.SLDPRT
24.0 x 15.0 x 15.0 mm
