ask4ska/ask4skaCyclone/Piezas y planos/Abraçadera Laser.SLDPRT

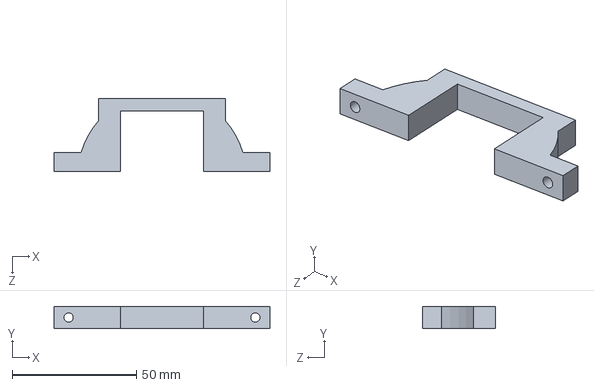
[picture p117: CAD file, 2017-06-02]
Piezas y planos/Abraçadera Laser.SLDPRT
87.1 x 9.00 x 29.3 mm
