ask4ska/ask4skaCyclone/Piezas y planos/Engranatge Z NEMAA.SLDPRT

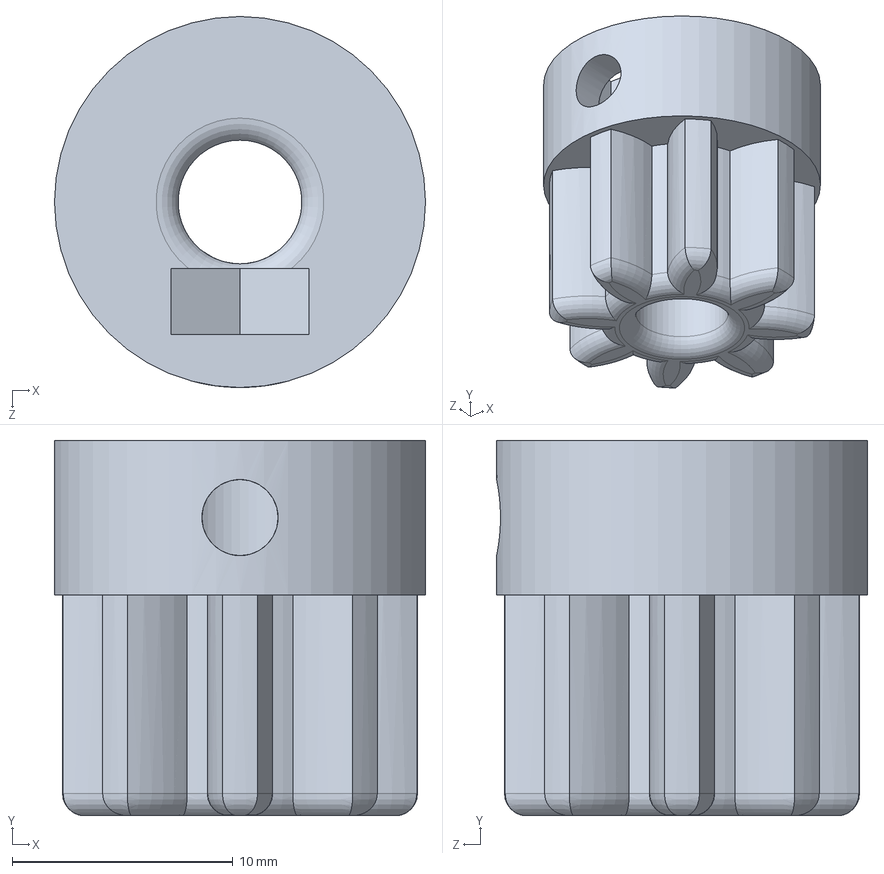
[picture p118: CAD file, 2017-06-02]
Piezas y planos/Engranatge Z NEMAA.SLDPRT
16.8 x 17.0 x 16.8 mm
