ask4ska/ask4skaCyclone/Piezas y planos/Soporte Dremel Superior Superior.2.SLDPRT

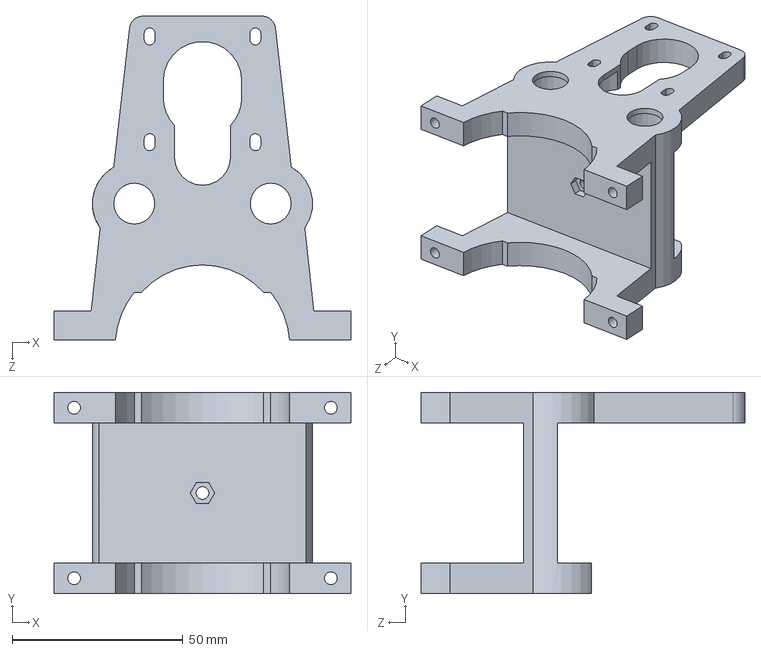
[picture p119: CAD file, 2017-06-02]
Piezas y planos/Soporte Dremel Superior Superior.2.SLDPRT
87.1 x 59.0 x 95.0 mm
