ask4ska/ask4skaCyclone/Piezas y planos/Chapa desplegada - carcassa esquerra.DXF

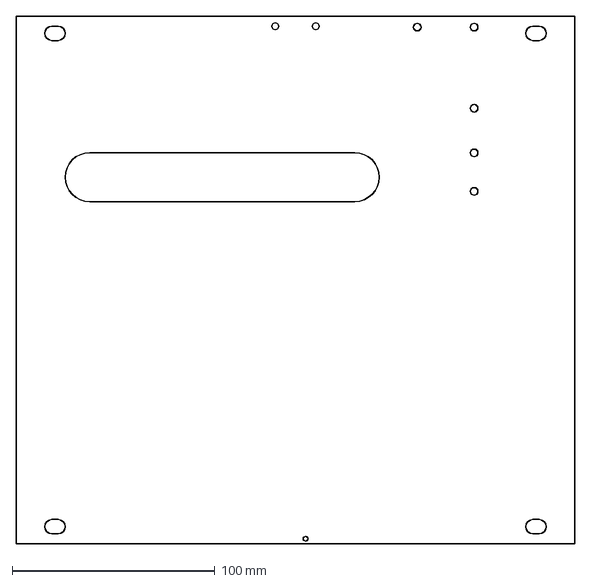
[picture p120: CAD file, 2017-06-02]
Piezas y planos/Chapa desplegada - carcassa esquerra.DXF
275.0 x 260.0 mm
