ask4ska/ask4skaCyclone/Piezas y planos/Separador rods.SLDPRT

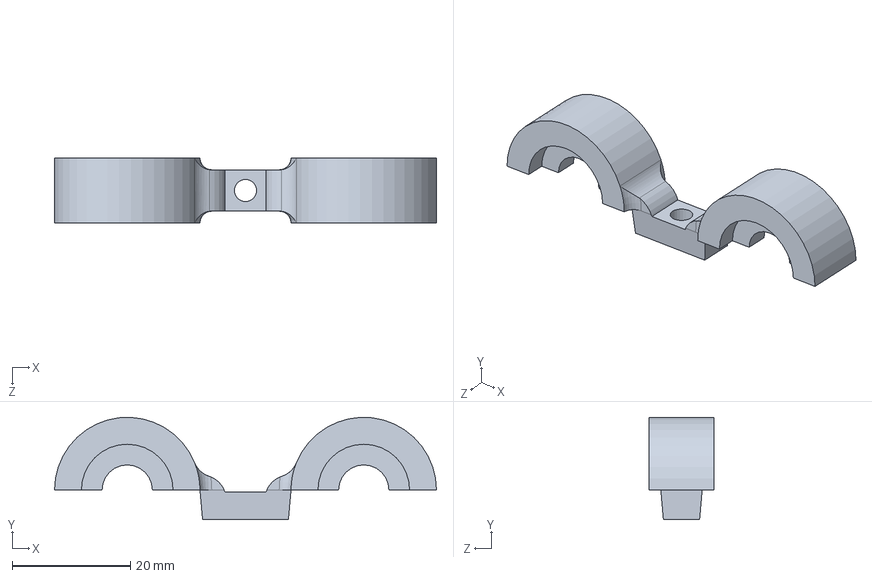
[picture p121: CAD file, 2017-06-02]
Piezas y planos/Separador rods.SLDPRT
64.6 x 17.3 x 11.0 mm
