ask4ska/ask4skaCyclone/Piezas y planos/Eje.SLDPRT

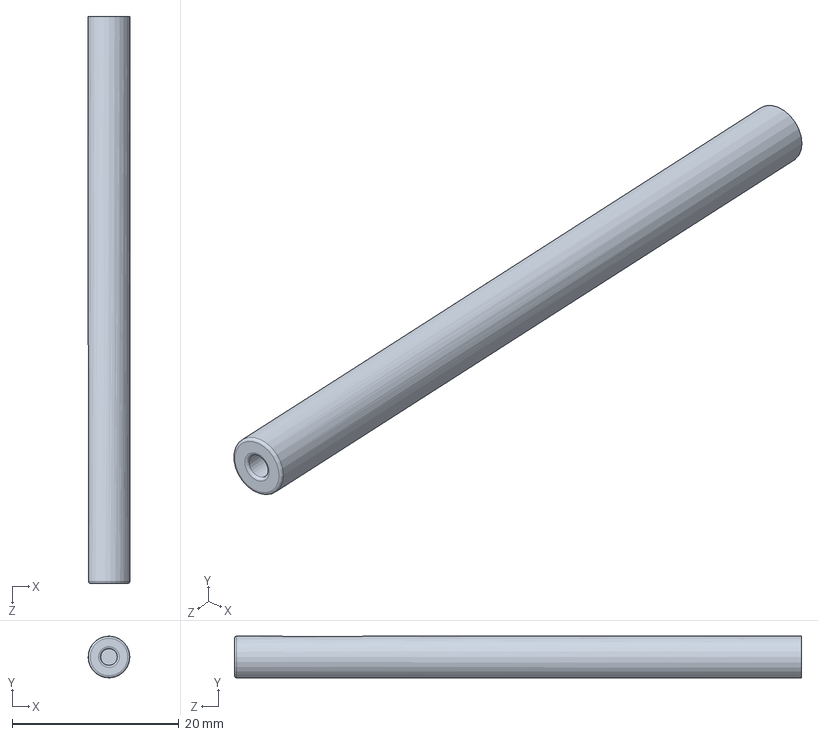
[picture p122: CAD file, 2017-06-02]
Piezas y planos/Eje.SLDPRT
5.00 x 5.00 x 68.0 mm
