ask4ska/ask4skaCyclone/(list of files, cad)

Other CAD files:
Piezas y planos/carcassa davant.SLDPRT
Piezas y planos/carcassa esquerra.SLDPRT
Piezas y planos/instrument ball bearing_68_am.sldprt
Piezas y planos/Abraçadora Patí Superior.SLDDRW
Piezas y planos/Anclatge 155.SLDDRW
Piezas y planos/Anclatge 75.SLDDRW
Piezas y planos/Autolevel.SLDDRW
Piezas y planos/AutolevelV.2.SLDPRT
Piezas y planos/Base Carcassa.SLDDRW
Piezas y planos/Caixa electrònica.SLDDRW
Piezas y planos/Carcassa Dreta.SLDDRW
Piezas y planos/Carcassa Esquerra.SLDDRW
Piezas y planos/Carro Central.SLDDRW
Piezas y planos/Engranatge Z roscat.SLDDRW
Piezas y planos/Fixador varilla llisa superior.SLDDRW
Piezas y planos/Fixador varilla llisa.SLDDRW
Piezas y planos/Patí Superior.SLDDRW
Piezas y planos/Patí dret.SLDDRW
Piezas y planos/Patí esquerra.SLDDRW
Piezas y planos/Separador Finals de Cursa.SLDDRW
Piezas y planos/Separador Rodaments.SLDDRW
Piezas y planos/hex nut gradec_din.sldprt
Piezas y planos/hex thin nut gradeb_din.sldprt
Piezas y planos/hex thin nut gradeb_iso.sldprt
Piezas y planos/plain washer grade a_din.sldprt
Piezas y planos/prevailing torque nut style 1 insert_din.sldprt
Piezas y planos/socket countersunk head screw_din.sldprt
Piezas y planos/socket head cap screw_din.sldprt
Piezas y planos/socket set screw flat point_iso.sldprt
