ask4ska/ask4skaCyclone/Planos fabricación.pdf

63 | 86 | 87 | 68 | 28 | 29

## N.º DE

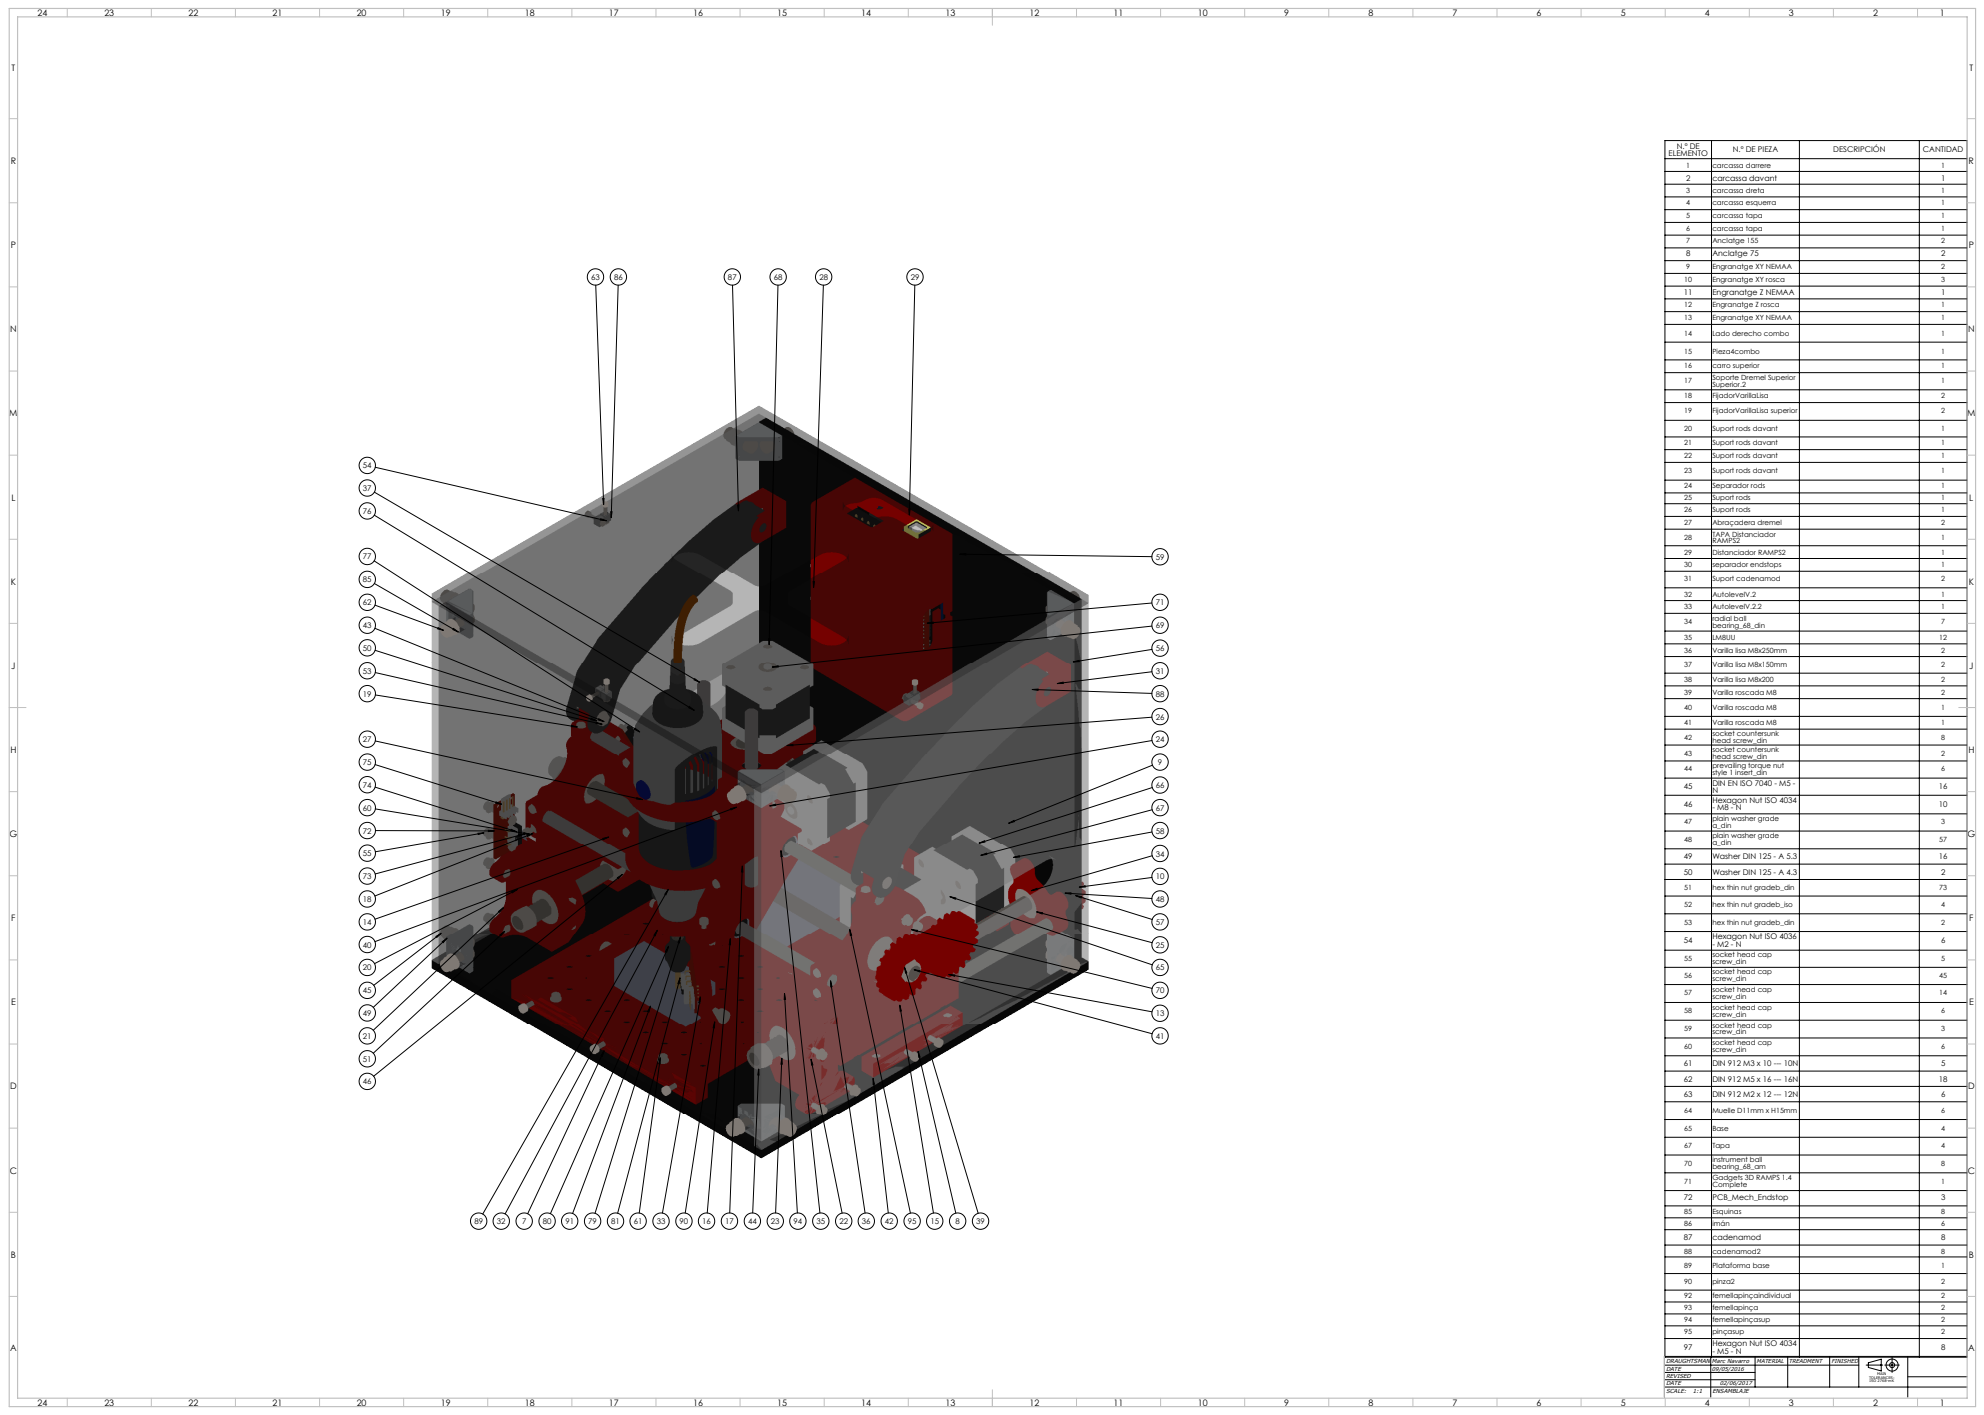
[picture p123: page 1]
ELEMENTO; N.º DE PIEZA; DESCRIPCIÓN; CANTIDAD 1; carcassa darrere; carcassa davant; carcassa dreta; carcassa esquerra; carcassa tapa; Anclatge 155; Anclatge 75; Engranatge XY NEMAA; Engranatge XY rosca; Engranatge Z NEMAA; SCALE: 1:1 ENSAMBLAJE; REVISED

12 | Engranatge Z rosca | | 1
13 | Engranatge XY NEMAA | | 1
14 | Lado derecho combo | | 1
15 | Pieza4combo | | 1
16 | carro superior | | 1
17 | Soporte Dremel Superior Superior.2 | | 1
18 | FijadorVarillaLisa | | 2
19 | FijadorVarillaLisa superior | | 2
20 | Suport rods davant | | 1
21 | Suport rods davant | | 1
22 | Suport rods davant | | 1
23 | Suport rods davant | | 1
24 | Separador rods | | 1
25 | Suport rods | | 1
26 | Suport rods | | 1
27 | Abraçadera dremel | | 2
28 | TAPA Distanciador RAMPS2 | | 1
29 | Distanciador RAMPS2 | | 1
30 | separador endstops | | 1
31 | Suport cadenamod | | 2
32 | AutolevelV.2 | | 1
33 | AutolevelV.2.2 | | 1
34 | radial ball bearing_68_din | | 7

35 | LM8UU | | 12
36 | Varilla lisa M8x250mm | | 2
37 | Varilla lisa M8x150mm | | 2
38 | Varilla lisa M8x200 | | 2
39 | Varilla roscada M8 | | 2
40 | Varilla roscada M8 | | 1
41 | Varilla roscada M8 | | 1
42 | socket countersunk head screw_din | | 8
43 | socket countersunk head screw_din | | 2
44 | prevailing torque nut style 1 insert_din | | 6
45 | DIN EN ISO 7040 - M5 - N | | 16
46 | Hexagon Nut ISO 4034 - M8 - N | | 10

47 | plain washer grade a_din | | 3
48 | plain washer grade a_din | | 57
49 | Washer DIN 125 - A 5.3 | | 16
50 | Washer DIN 125 - A 4.3 | | 2
51 | hex thin nut gradeb_din | | 73
52 | hex thin nut gradeb_iso | | 4
53 | hex thin nut gradeb_din | | 2
54 | Hexagon Nut ISO 4036 - M2 - N | | 6

55 | socket head cap screw_din | | 5
56 | socket head cap screw_din | | 45
57 | socket head cap screw_din | | 14
58 | socket head cap screw_din | | 6
59 | socket head cap screw_din | | 3
60 | socket head cap screw_din | | 6
61 | DIN 912 M3 x 10 --- 10N | | 5
62 | DIN 912 M5 x 16 --- 16N | | 18
63 | DIN 912 M2 x 12 --- 12N | | 6
64 | Muelle D11mm x H15mm | | 6
65 | Base | | 4
67 | Tapa | | 4
70 | instrument ball bearing_68_am | | 8
71 | Gadgets 3D RAMPS 1.4 Complete | | 1
72 | PCB_Mech_Endstop | | 3
85 | Esquinas | | 8
86 | imán | | 6
87 | cadenamod | | 8
88 | cadenamod2 | | 8
89 | Plataforma base | | 1
90 | pinza2 | | 2
92 | femellapinçaindividual | | 2
93 | femellapinça | | 2
94 | femellapinçasup | | 2
95 | pinçasup | | 2
97 | Hexagon Nut ISO 4034 - M5 - N | | 8

DRAUGHTSMAN Marc Navarro DATE | MATERIAL | TREADMENT | FINISHED | MAIN TOLERANCES: ISO 2768-mK DATE

N8

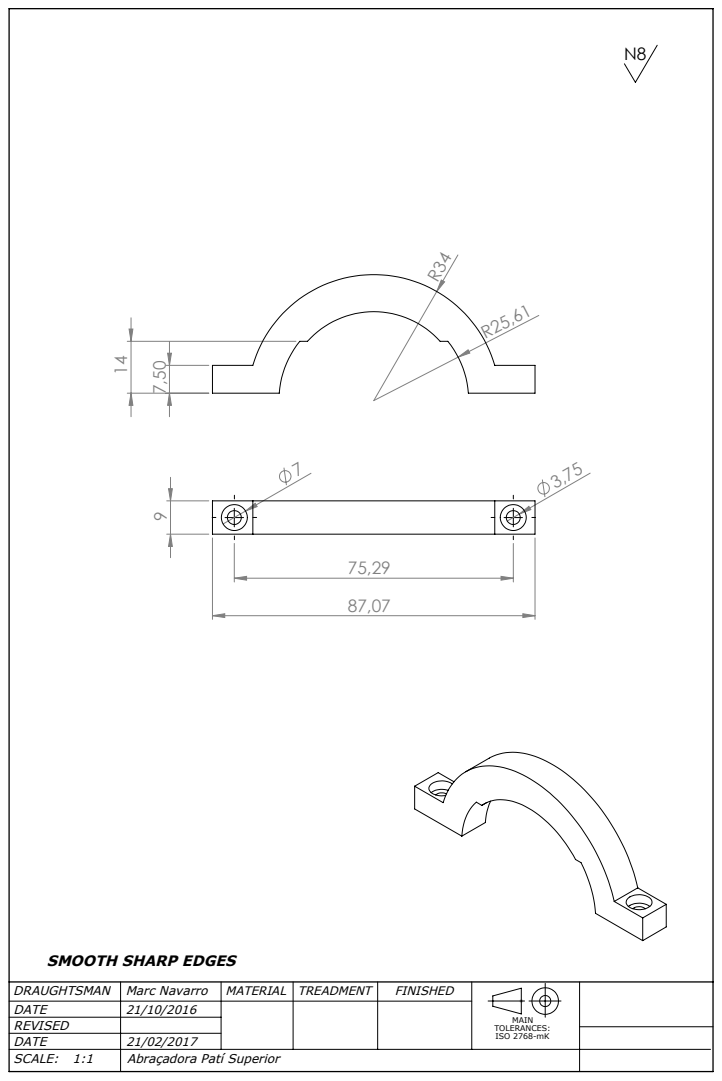
[picture p124: page 2]
MAIN TOLERANCES:; ISO 2768-mK; Marc Navarro; TREADMENT; FINISHED; DRAUGHTSMAN; SCALE: 1:1; Abraçadora Patí Superior; MATERIAL

SMOOTH SHARP EDGES

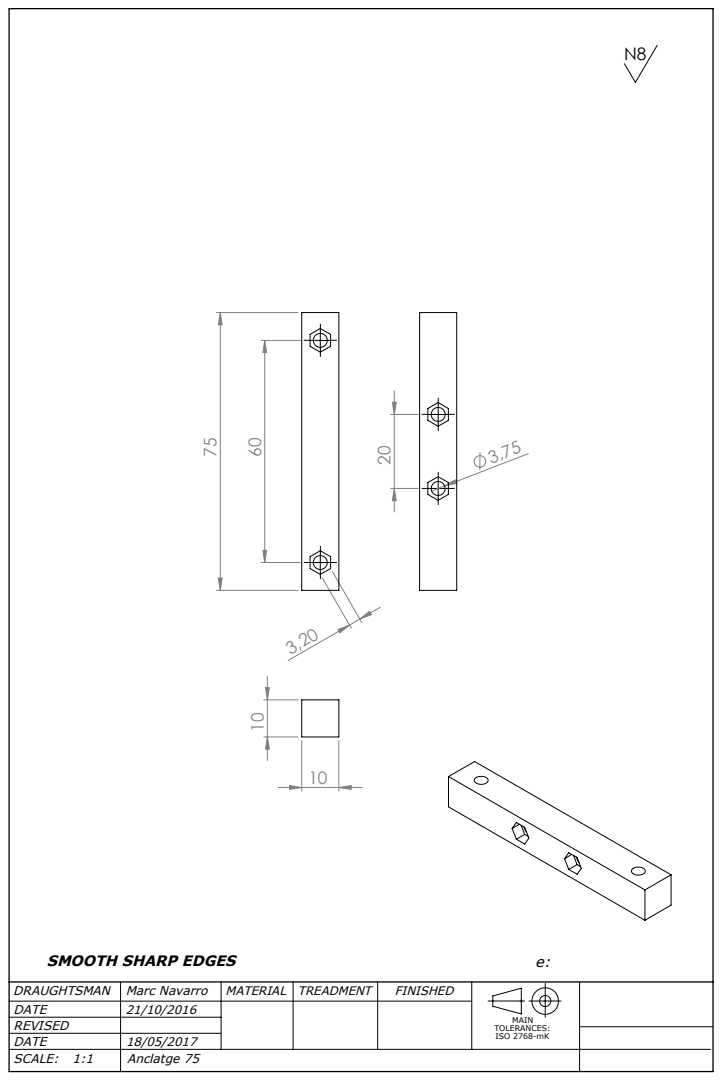
[picture p125: page 3]
Marc Navarro; TREADMENT; FINISHED; DRAUGHTSMAN; SCALE: 1:1; Anclatge 75; MATERIAL

SMOOTH SHARP EDGES

C

D

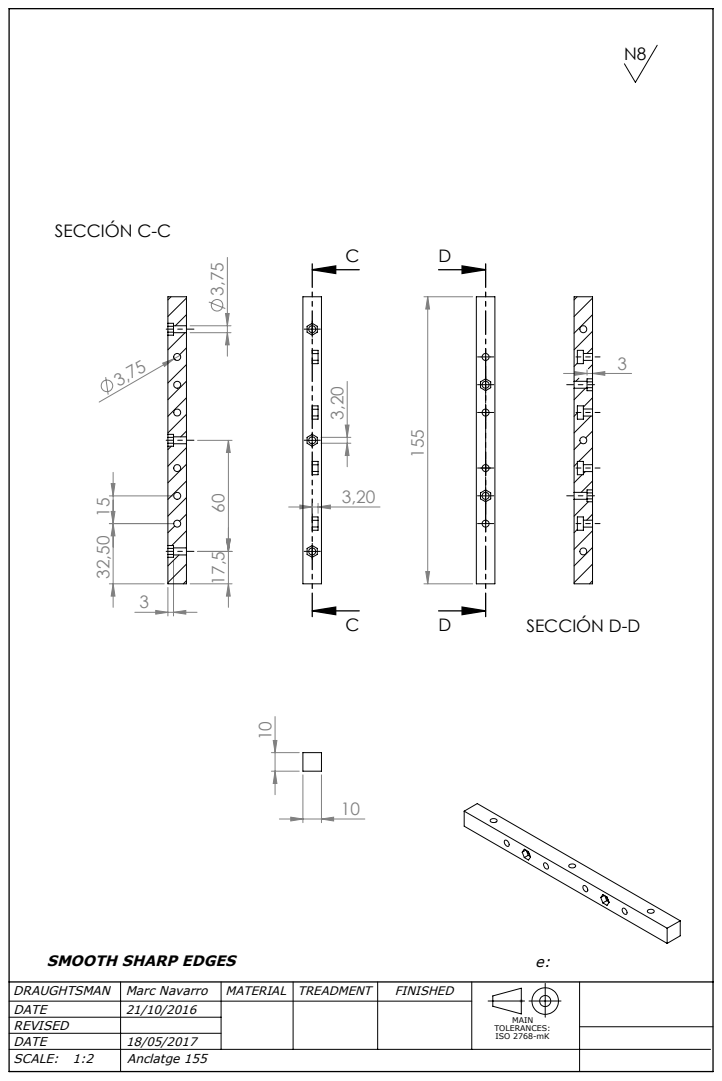
[picture p126: page 4]
SECCIÓN C-C; SECCIÓN D-D; Marc Navarro; TREADMENT; FINISHED; DRAUGHTSMAN; SCALE: 1:2; Anclatge 155; MATERIAL

SMOOTH SHARP EDGES

9,80
5,80

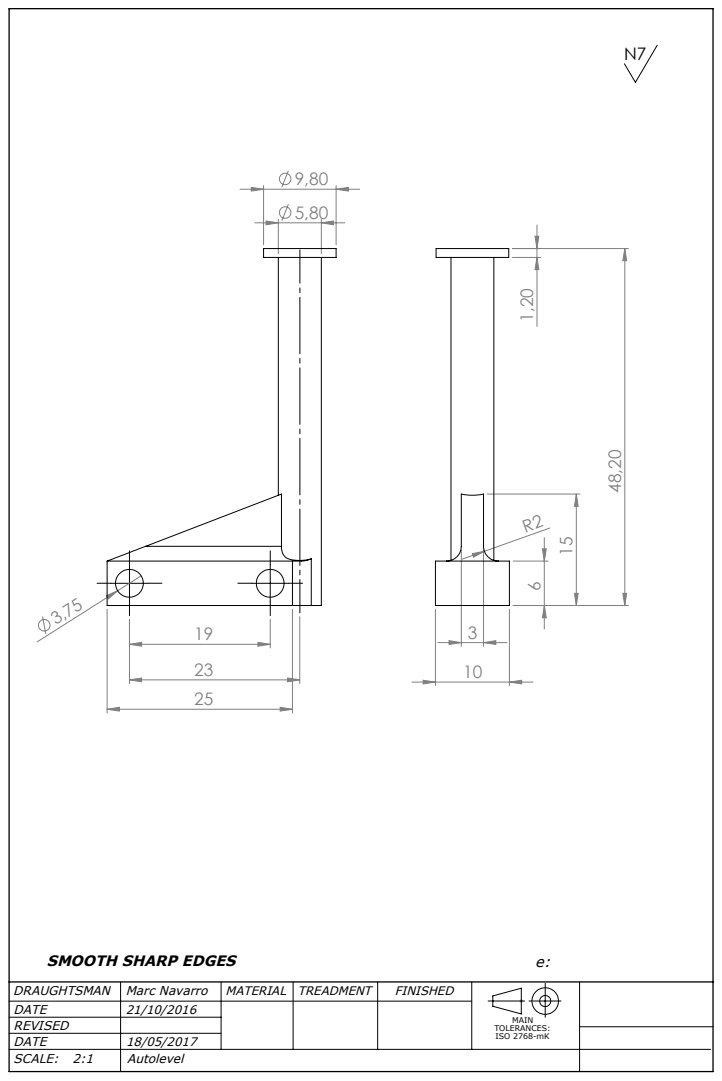
[picture p127: page 5]
Marc Navarro; TREADMENT; FINISHED; DRAUGHTSMAN; SCALE: 2:1; Autolevel; MATERIAL

SMOOTH SHARP EDGES

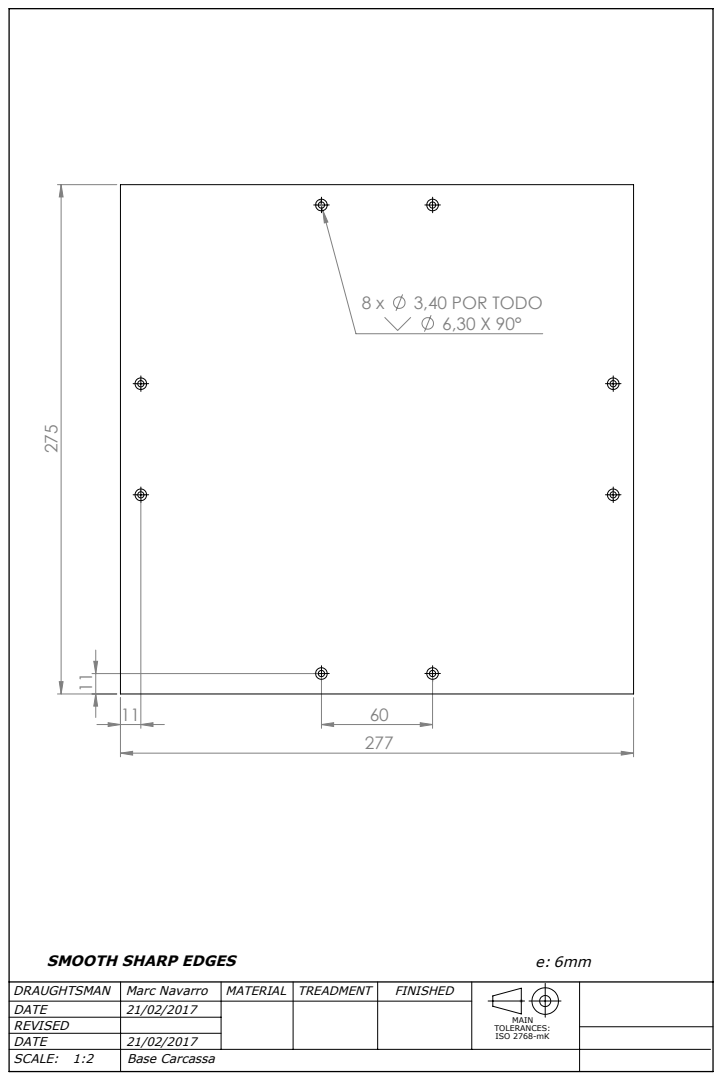
[picture p128: page 6]
3,40 POR TODO; Marc Navarro; TREADMENT; FINISHED; DRAUGHTSMAN; SCALE: 1:2; Base Carcassa; MATERIAL

SMOOTH SHARP EDGES

## SECCIÓN B-B

82

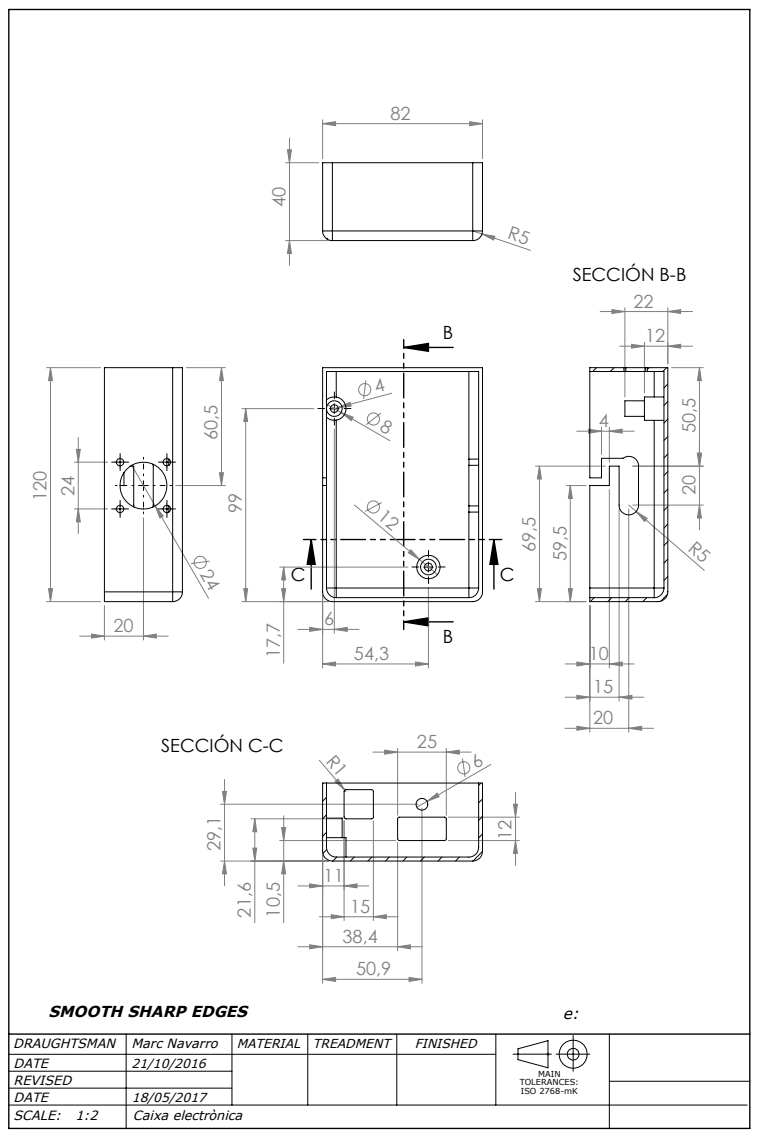
[picture p129: page 7]
SECCIÓN C-C; Marc Navarro; TREADMENT; FINISHED; DRAUGHTSMAN; SCALE: 1:2; Caixa electrònica; MATERIAL

SMOOTH SHARP EDGES

2,40

234

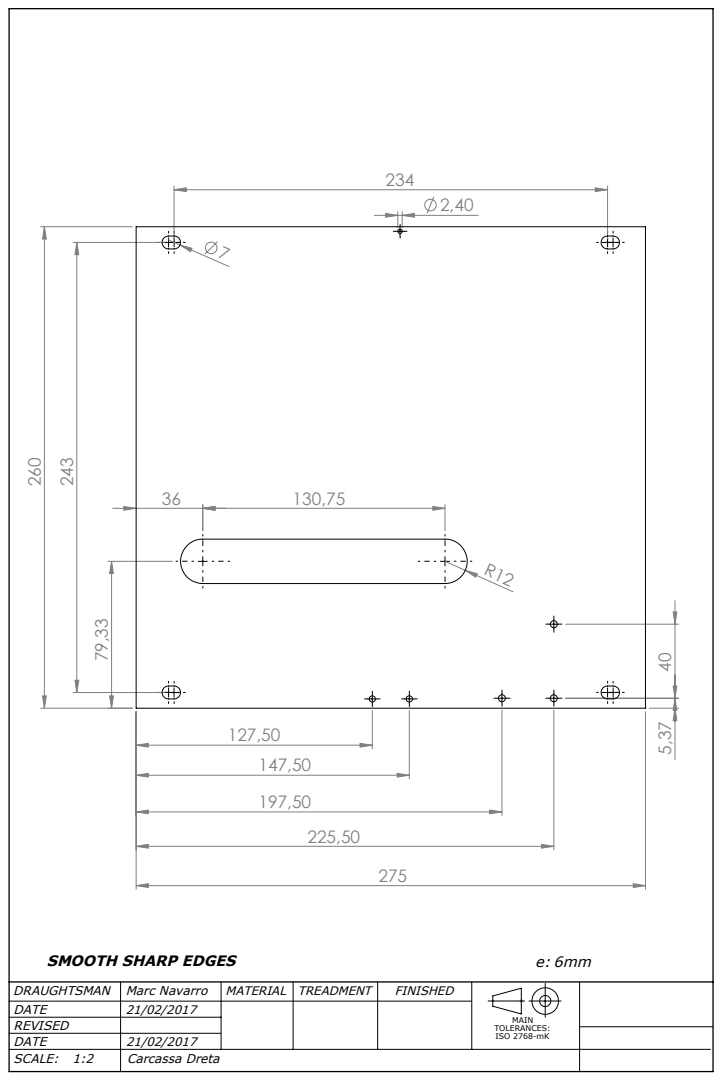
[picture p130: page 8]
Marc Navarro; TREADMENT; FINISHED; DRAUGHTSMAN; SCALE: 1:2; Carcassa Dreta; MATERIAL

SMOOTH SHARP EDGES

122,50

152,50

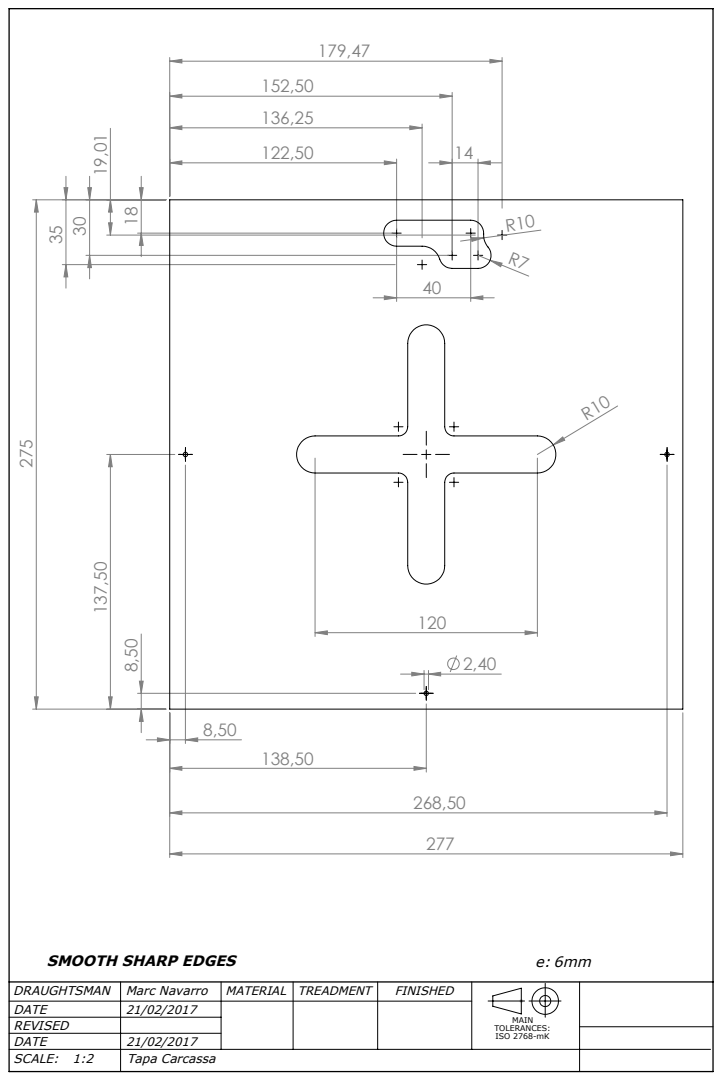
[picture p131: page 9]
Marc Navarro; TREADMENT; FINISHED; DRAUGHTSMAN; SCALE: 1:2; Tapa Carcassa; MATERIAL

SMOOTH SHARP EDGES

3
142,50

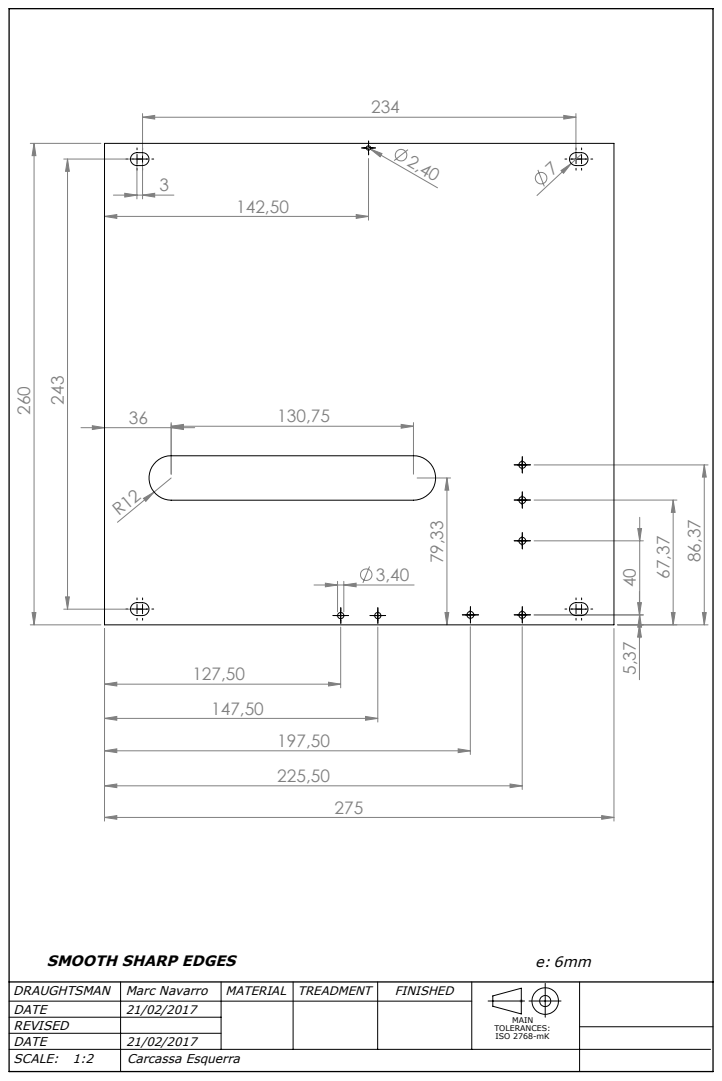
[picture p132: page 10]
Marc Navarro; TREADMENT; FINISHED; DRAUGHTSMAN; SCALE: 1:2; Carcassa Esquerra; MATERIAL

SMOOTH SHARP EDGES

37,88

29,45

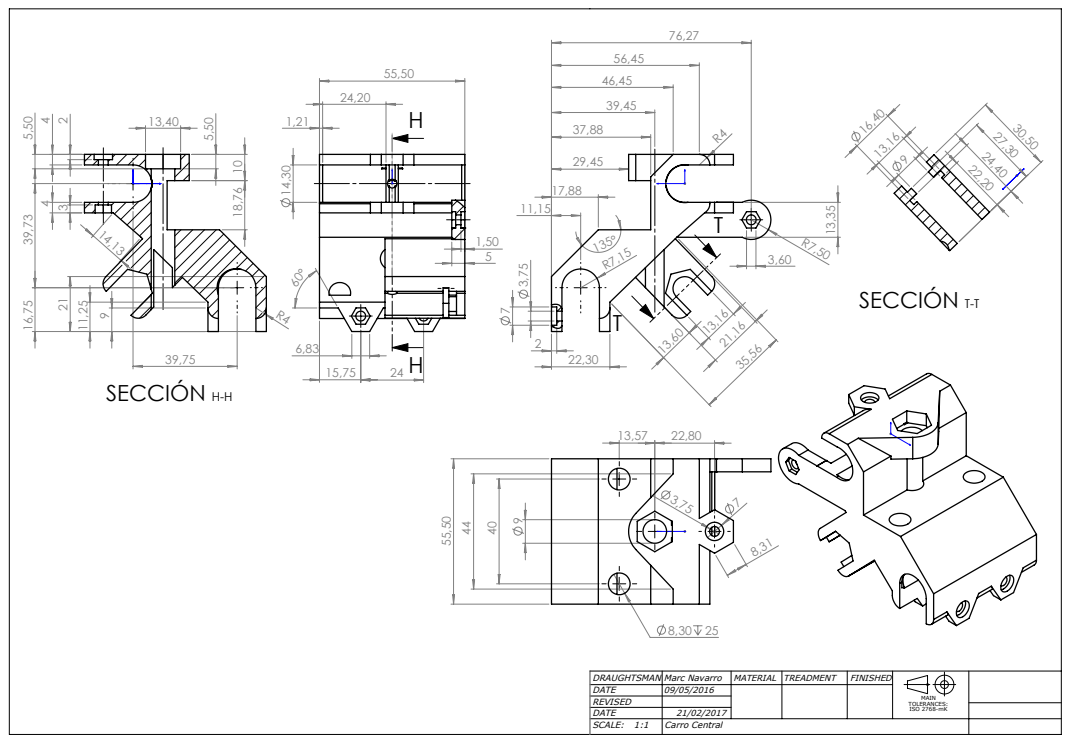
[picture p133: page 11]
SECCIÓN H-H; SECCIÓN T-T; MATERIAL; DATE; DRAUGHTSMAN; Marc Navarro; TREADMENT; FINISHED; MAIN TOLERANCES:

ISO 2768-mK DATE
SCALE: 1:1 Carro Central

8,70

A | A

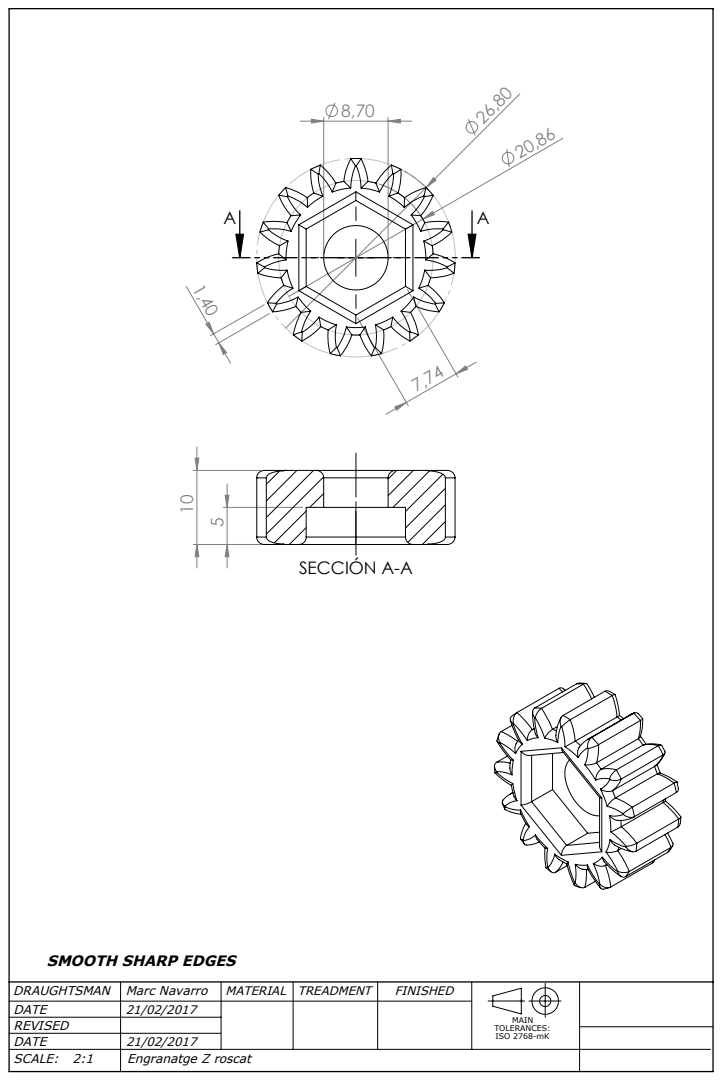
[picture p134: page 12]
SECCIÓN A-A; Marc Navarro; TREADMENT; FINISHED; DRAUGHTSMAN; SCALE: 2:1; Engranatge Z roscat; MATERIAL

SMOOTH SHARP EDGES

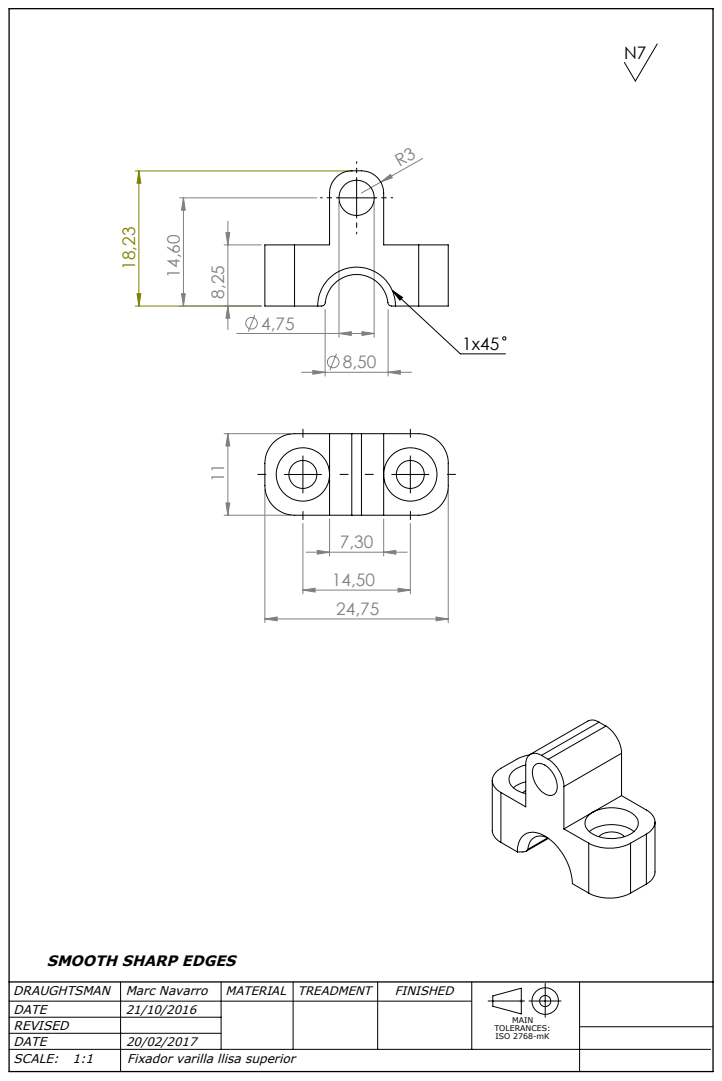
[picture p135: page 13]
Marc Navarro; TREADMENT; FINISHED; DRAUGHTSMAN; SCALE: 1:1; Fixador varilla llisa superior; MATERIAL

SMOOTH SHARP EDGES

7,20
3,78

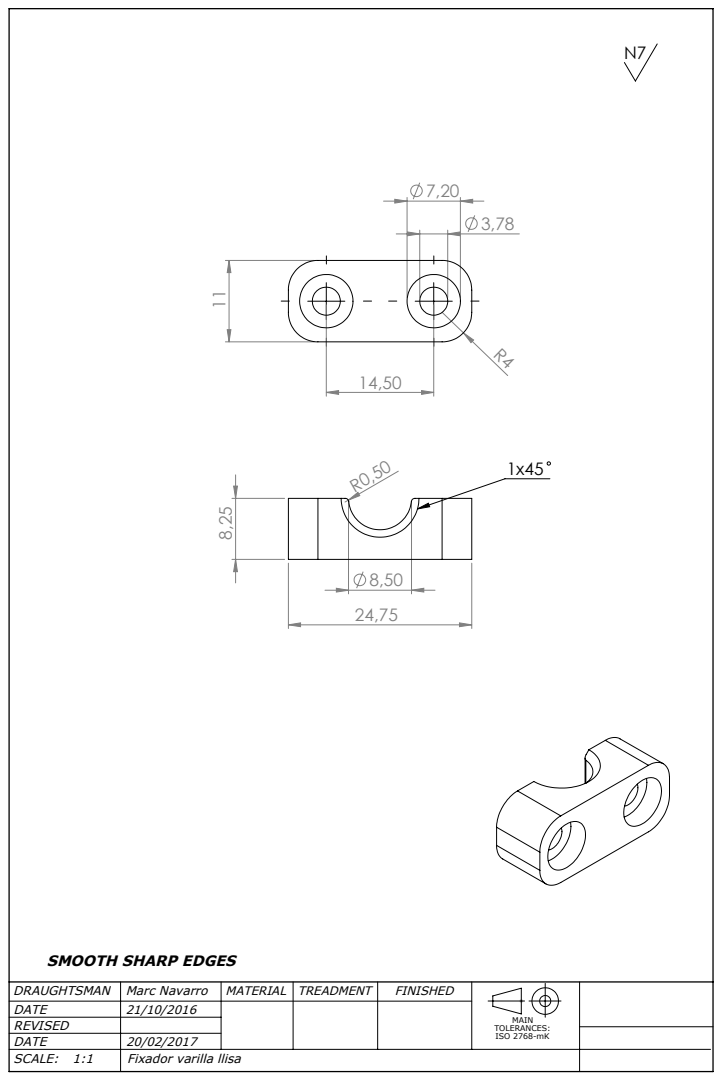
[picture p136: page 14]
Marc Navarro; TREADMENT; FINISHED; DRAUGHTSMAN; SCALE: 1:1; Fixador varilla llisa; MATERIAL

SMOOTH SHARP EDGES

36 | 39,75
| 28,11

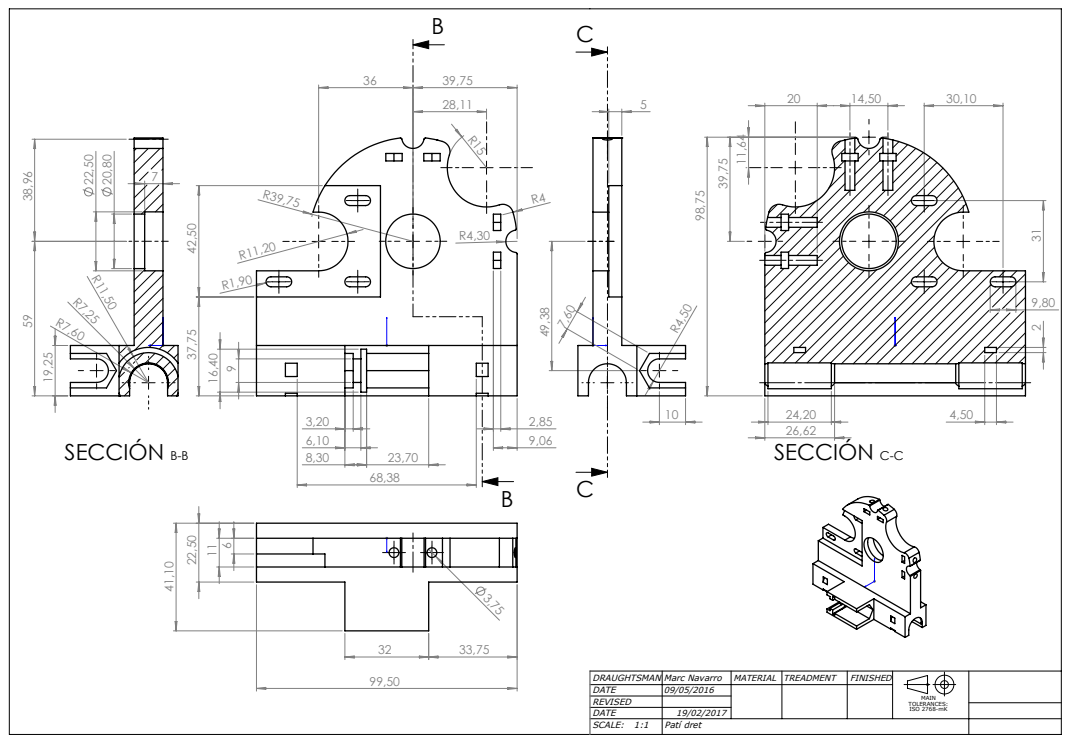
[picture p137: page 15]
SECCIÓN B-B; SECCIÓN C-C; MATERIAL; DATE; DRAUGHTSMAN; Marc Navarro; TREADMENT; FINISHED; MAIN TOLERANCES:

ISO 2768-mK DATE
SCALE: 1:1 Patí dret

39,75
28,29

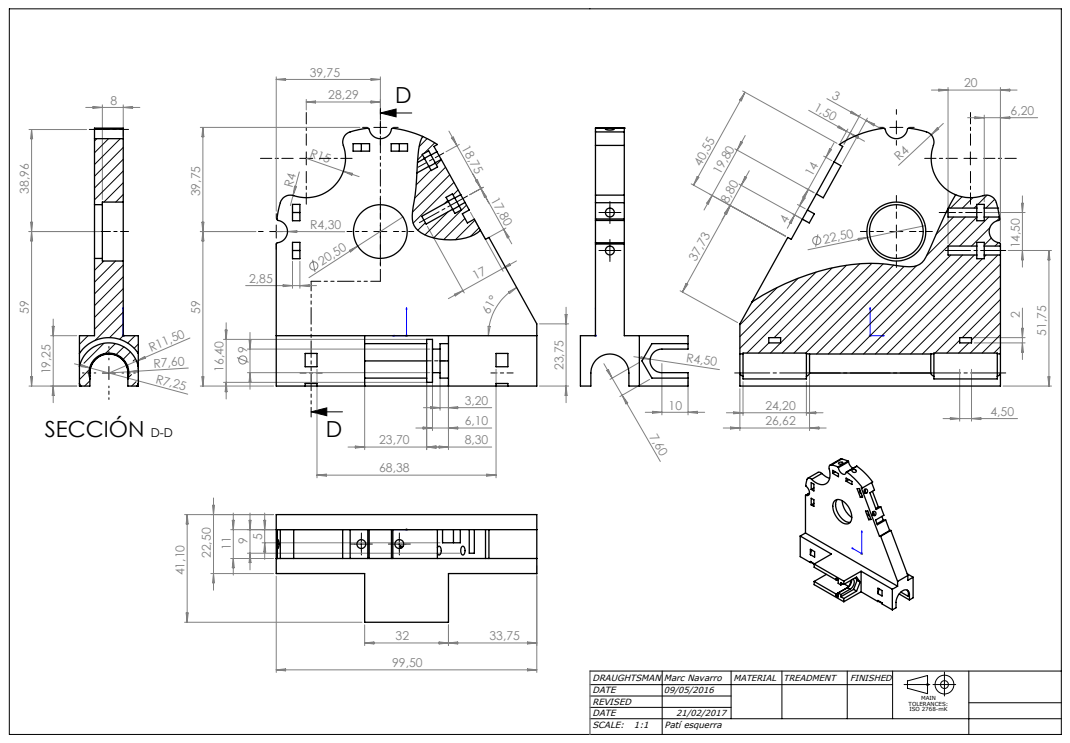
[picture p138: page 16]
SECCIÓN D-D; MATERIAL; DATE; DRAUGHTSMAN; Marc Navarro; TREADMENT; FINISHED; MAIN TOLERANCES:

ISO 2768-mK DATE
SCALE: 1:1 Patí esquerra

C

6,24

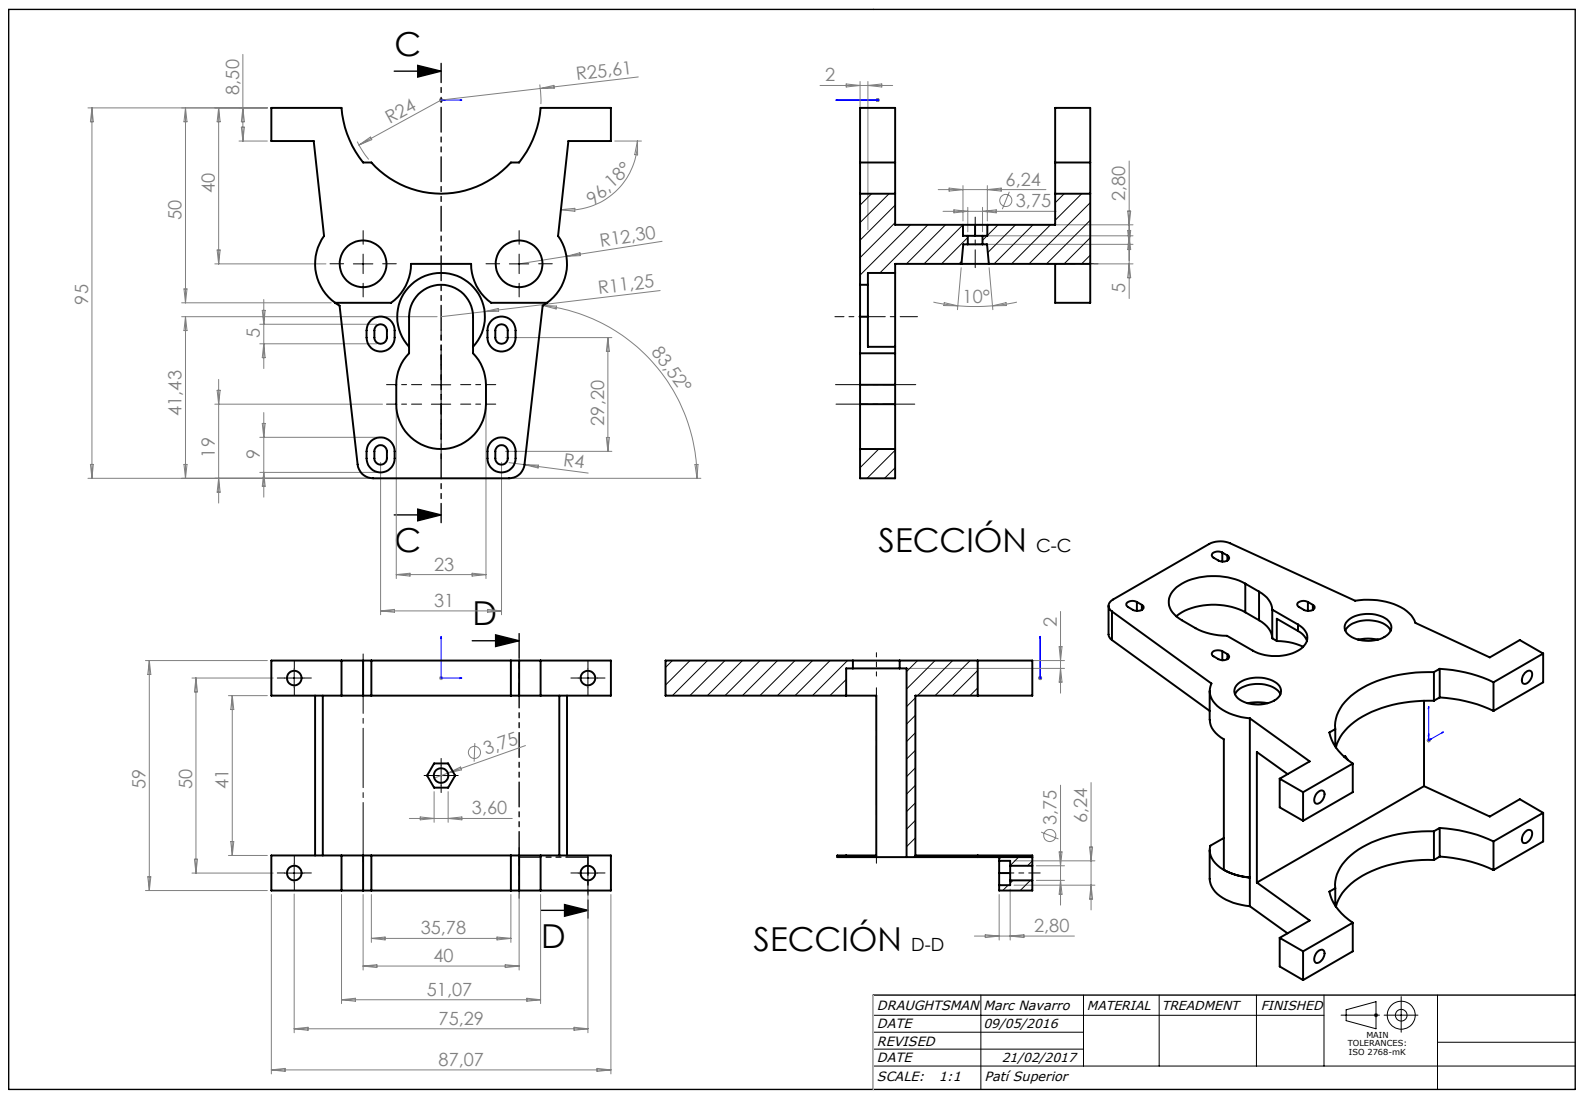
[picture p139: page 17]
SECCIÓN C-C; SECCIÓN D-D; MATERIAL; DATE; DRAUGHTSMAN; Marc Navarro; TREADMENT; FINISHED; MAIN TOLERANCES:

ISO 2768-mK DATE
SCALE: 1:1 Patí Superior

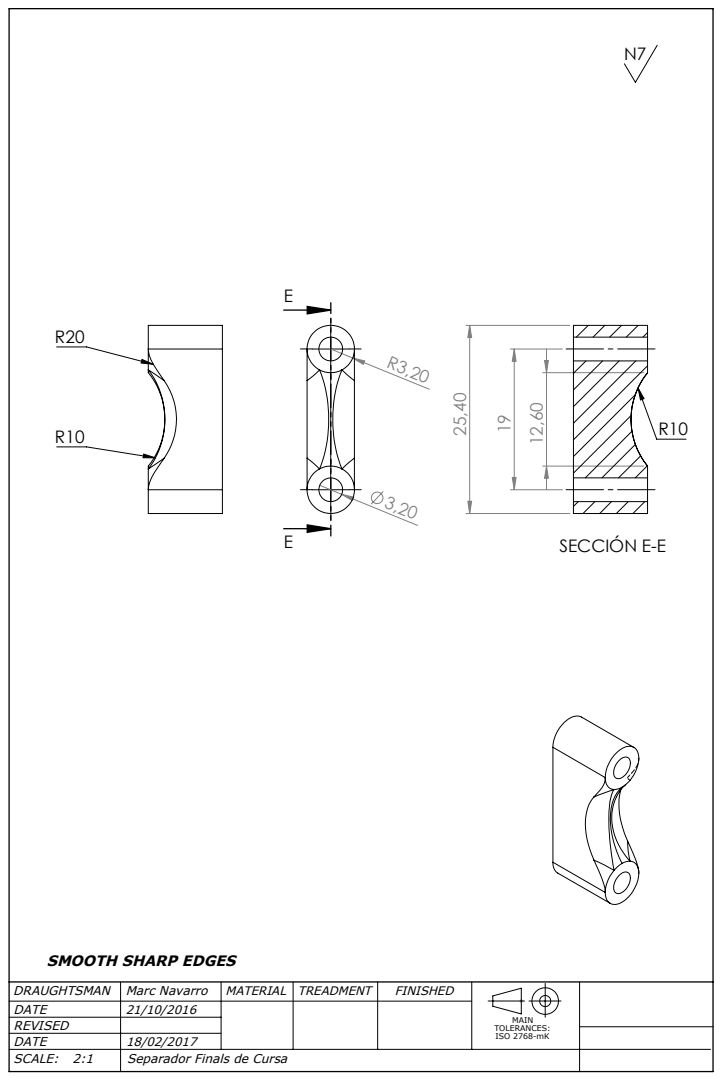
[picture p140: page 18]
SECCIÓN E-E; Marc Navarro; TREADMENT; FINISHED; DRAUGHTSMAN; SCALE: 2:1; Separador Finals de Cursa; MATERIAL

SMOOTH SHARP EDGES

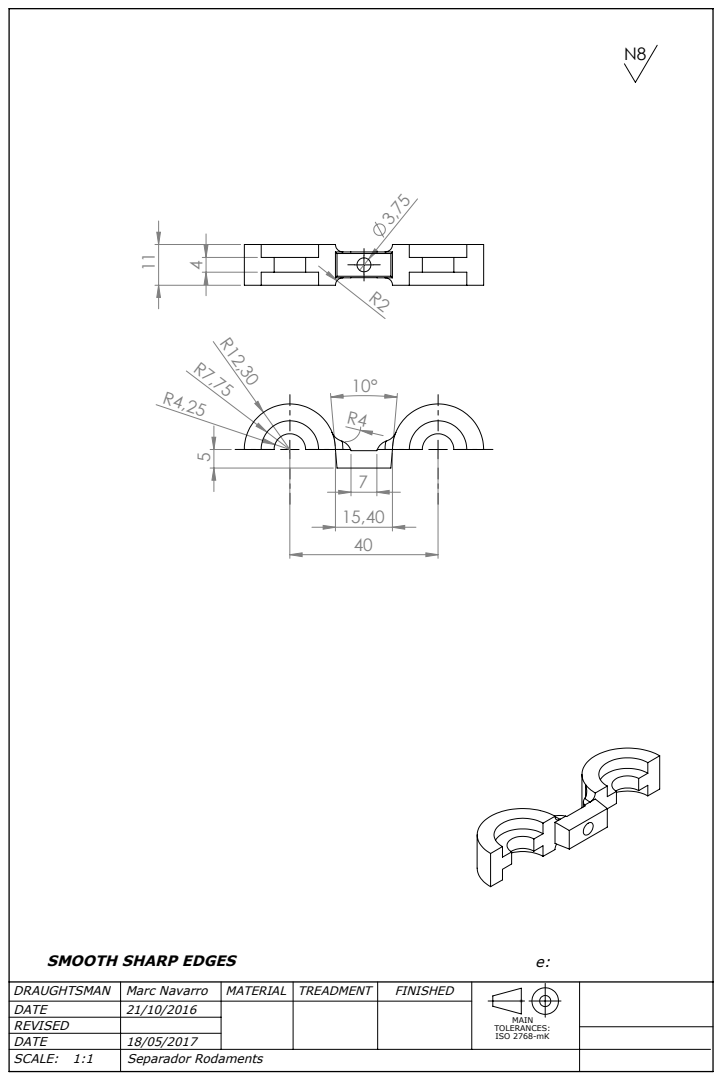
[picture p141: page 19]
Marc Navarro; TREADMENT; FINISHED; DRAUGHTSMAN; SCALE: 1:1; Separador Rodaments; MATERIAL

SMOOTH SHARP EDGES

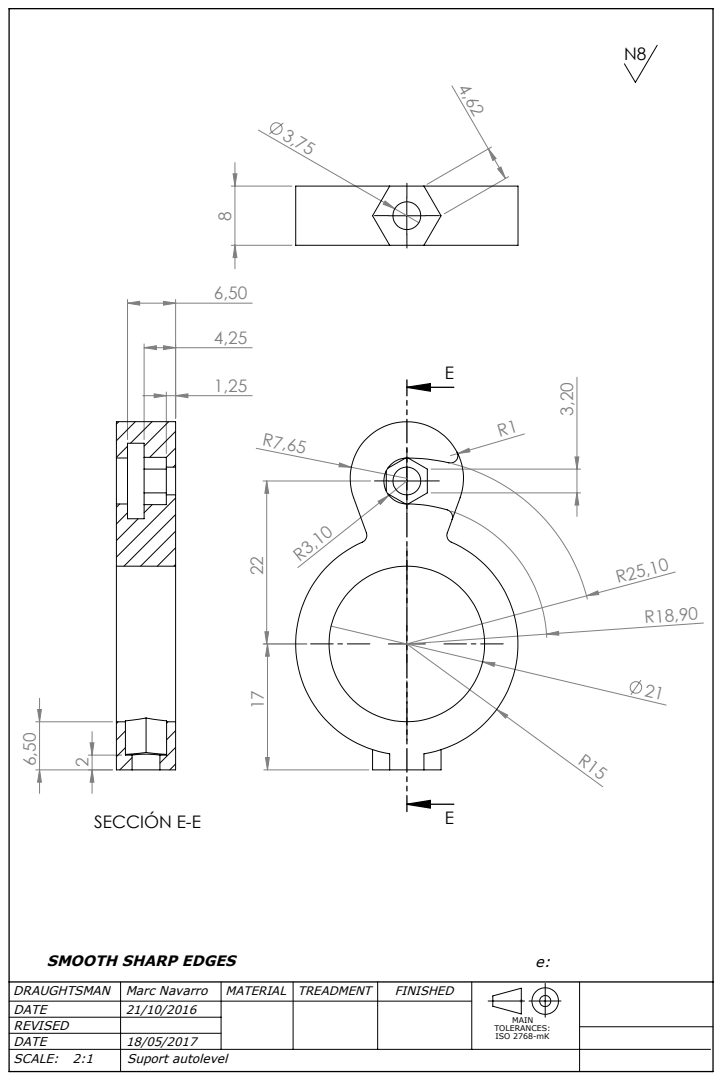
[picture p142: page 20]
SECCIÓN E-E; Marc Navarro; TREADMENT; FINISHED; DRAUGHTSMAN; SCALE: 2:1; Suport autolevel; MATERIAL

SMOOTH SHARP EDGES

21,85

19,85 6,15

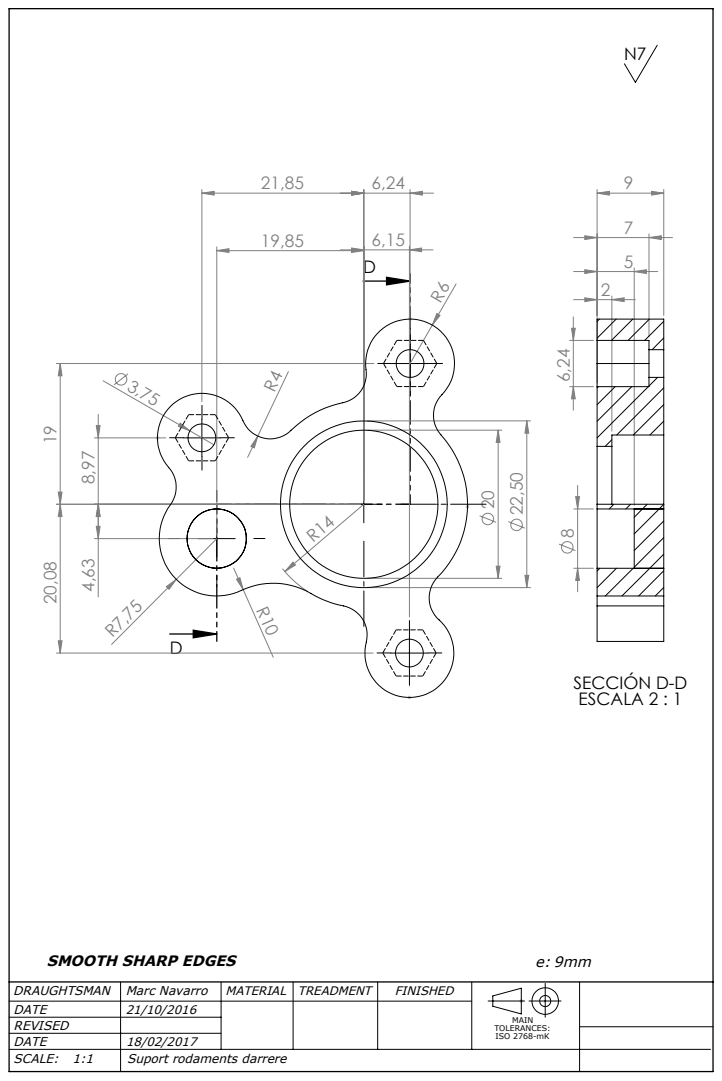
[picture p143: page 21]
SECCIÓN D-D ESCALA 2 : 1; Marc Navarro; TREADMENT; FINISHED; DRAUGHTSMAN; SCALE: 1:1; Suport rodaments darrere; MATERIAL

SMOOTH SHARP EDGES

## 20 X 5 POR TODO

22,50 7

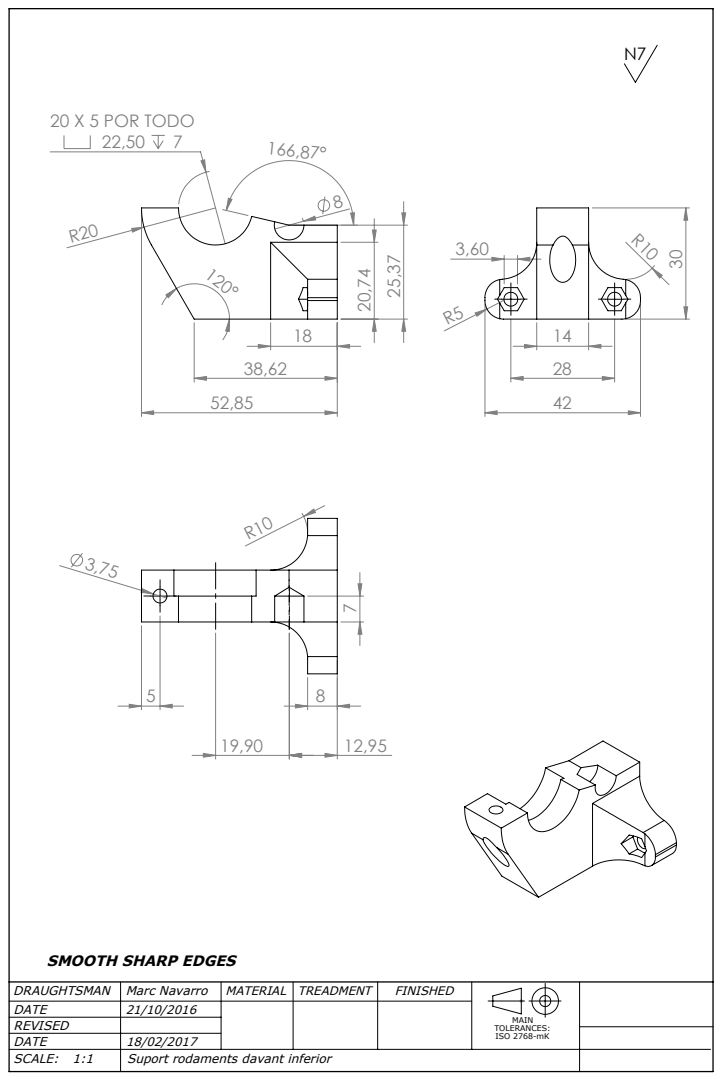
[picture p144: page 22]
Marc Navarro; TREADMENT; FINISHED; DRAUGHTSMAN; SCALE: 1:1; Suport rodaments davant inferior; MATERIAL

SMOOTH SHARP EDGES

7,20

3,75

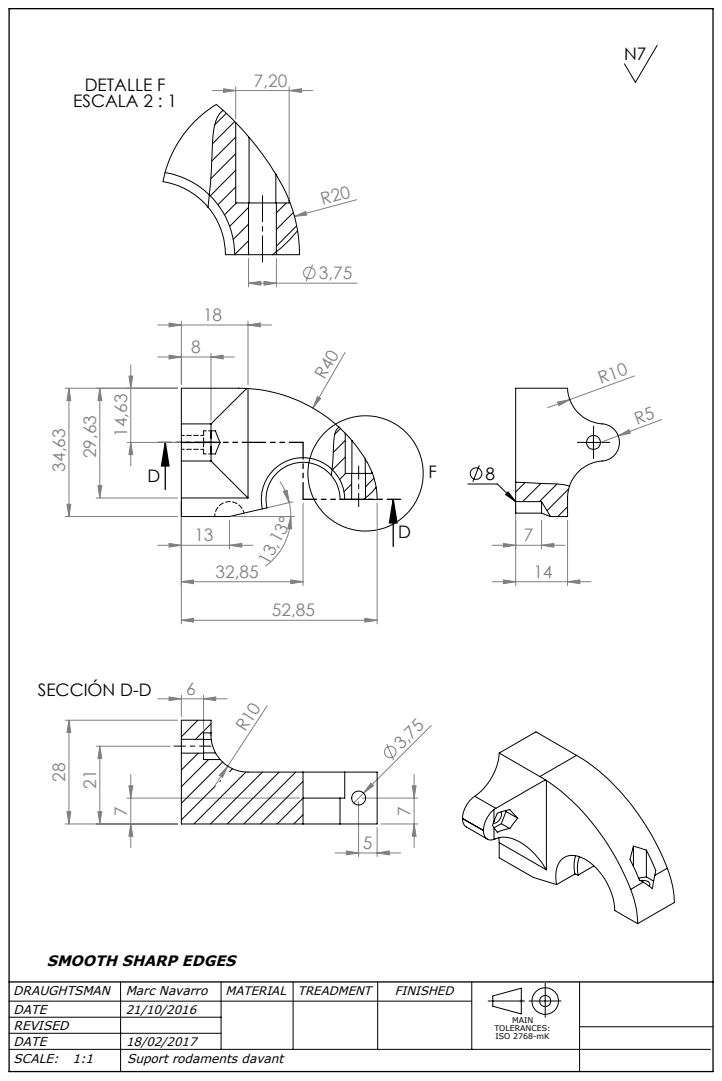
[picture p145: page 23]
SECCIÓN D-D; DETALLE F ESCALA 2 : 1; Marc Navarro; TREADMENT; FINISHED; DRAUGHTSMAN; SCALE: 1:1; Suport rodaments davant; MATERIAL

SMOOTH SHARP EDGES

122,50

152,50

SMOOTH SHARP EDGES

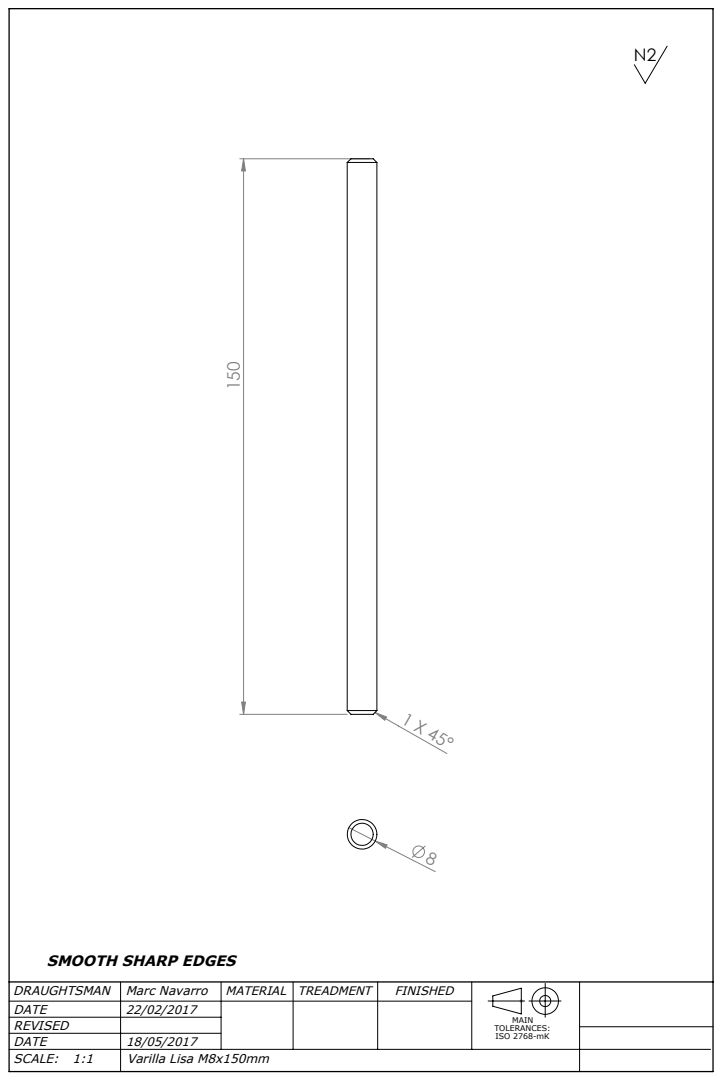
[picture p146: page 25]
Marc Navarro; TREADMENT; FINISHED; DRAUGHTSMAN; SCALE: 1:1; Varilla Lisa M8x150mm; MATERIAL

SMOOTH SHARP EDGES

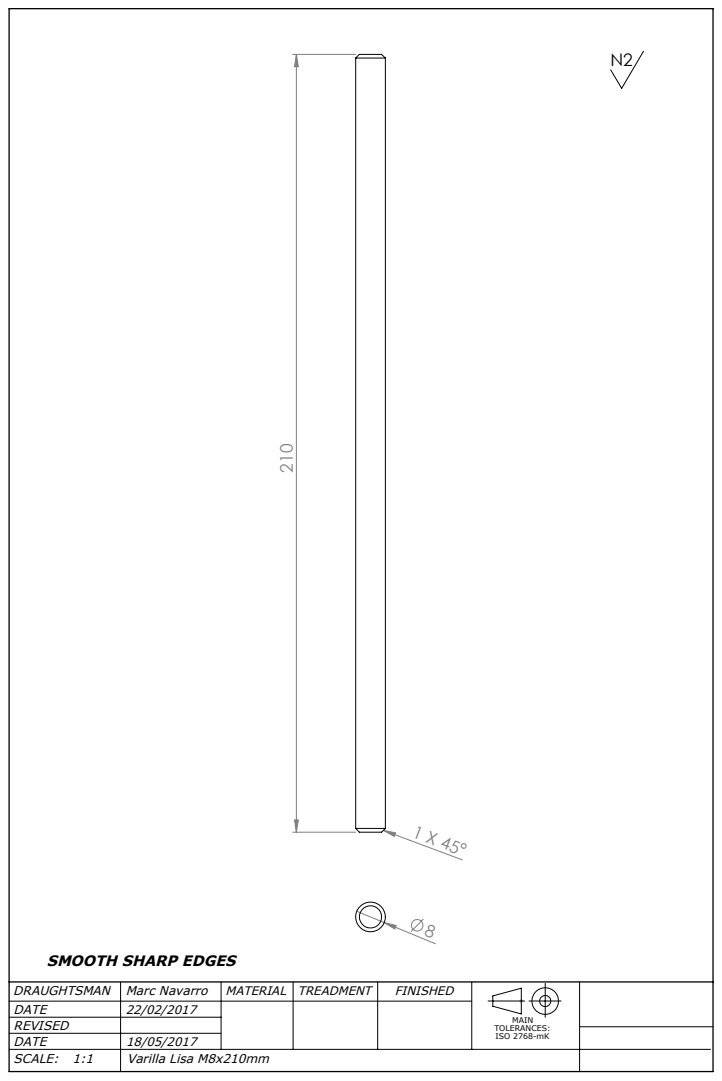
[picture p147: page 26]
Marc Navarro; TREADMENT; FINISHED; DRAUGHTSMAN; SCALE: 1:1; Varilla Lisa M8x210mm; MATERIAL

SMOOTH SHARP EDGES

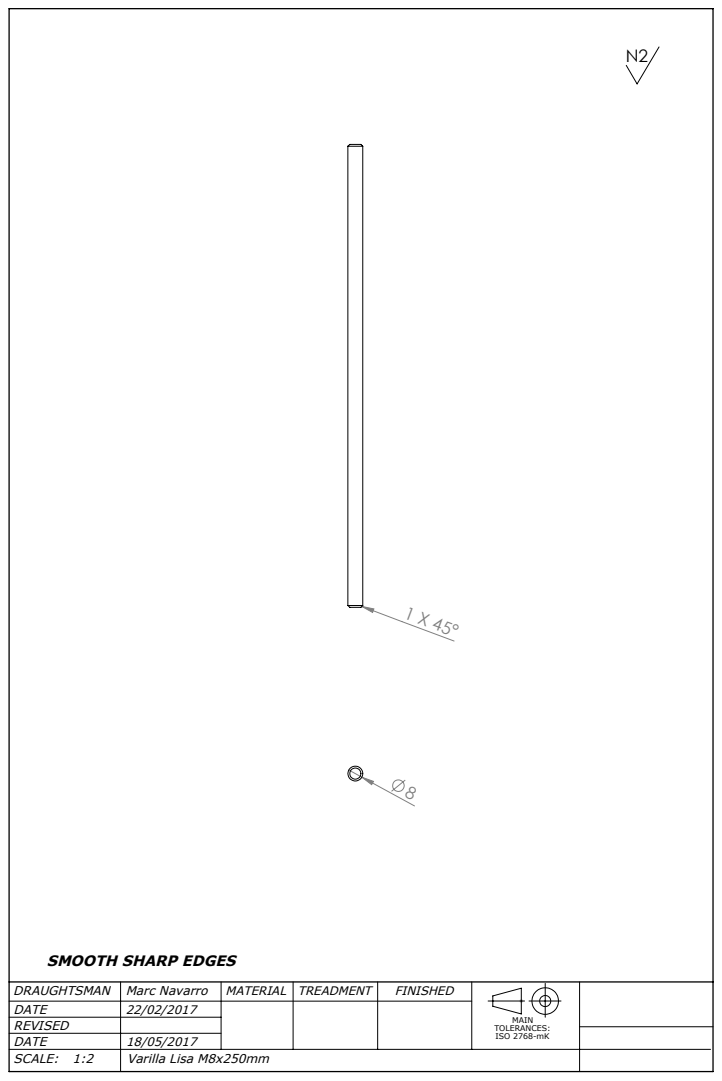
[picture p148: page 27]
Marc Navarro; TREADMENT; FINISHED; DRAUGHTSMAN; SCALE: 1:2; Varilla Lisa M8x250mm; MATERIAL

SMOOTH SHARP EDGES
