ask4ska/ask4skaCyclone/(commit log)

2017-05-31 Electronics for Cyclone-PCB-Factory
    Electronics for Cyclone-PCB-Factory.
2017-06-12 Create Youtube
    Mini tutorial de vectorización y uso
